El-Luhb/LattePanda-Mu/(threads)

Thread 2 (2024-05-25):

Mounting Holes on the nvme Carrier

El-Luhb, 2024-05-25:
Mounting holes must be checked to ensure that they have the correct dimensions

Closed 2024-09-20.
