El-Luhb/LattePanda-Mu/Electricals/Examples/nvme Carrier for LattePanda Mu/LattePanda Module.kicad_sch

## KiCad design Electricals/Examples/nvme Carrier for LattePanda Mu/LattePanda Module.kicad_sch (2024-06-21)

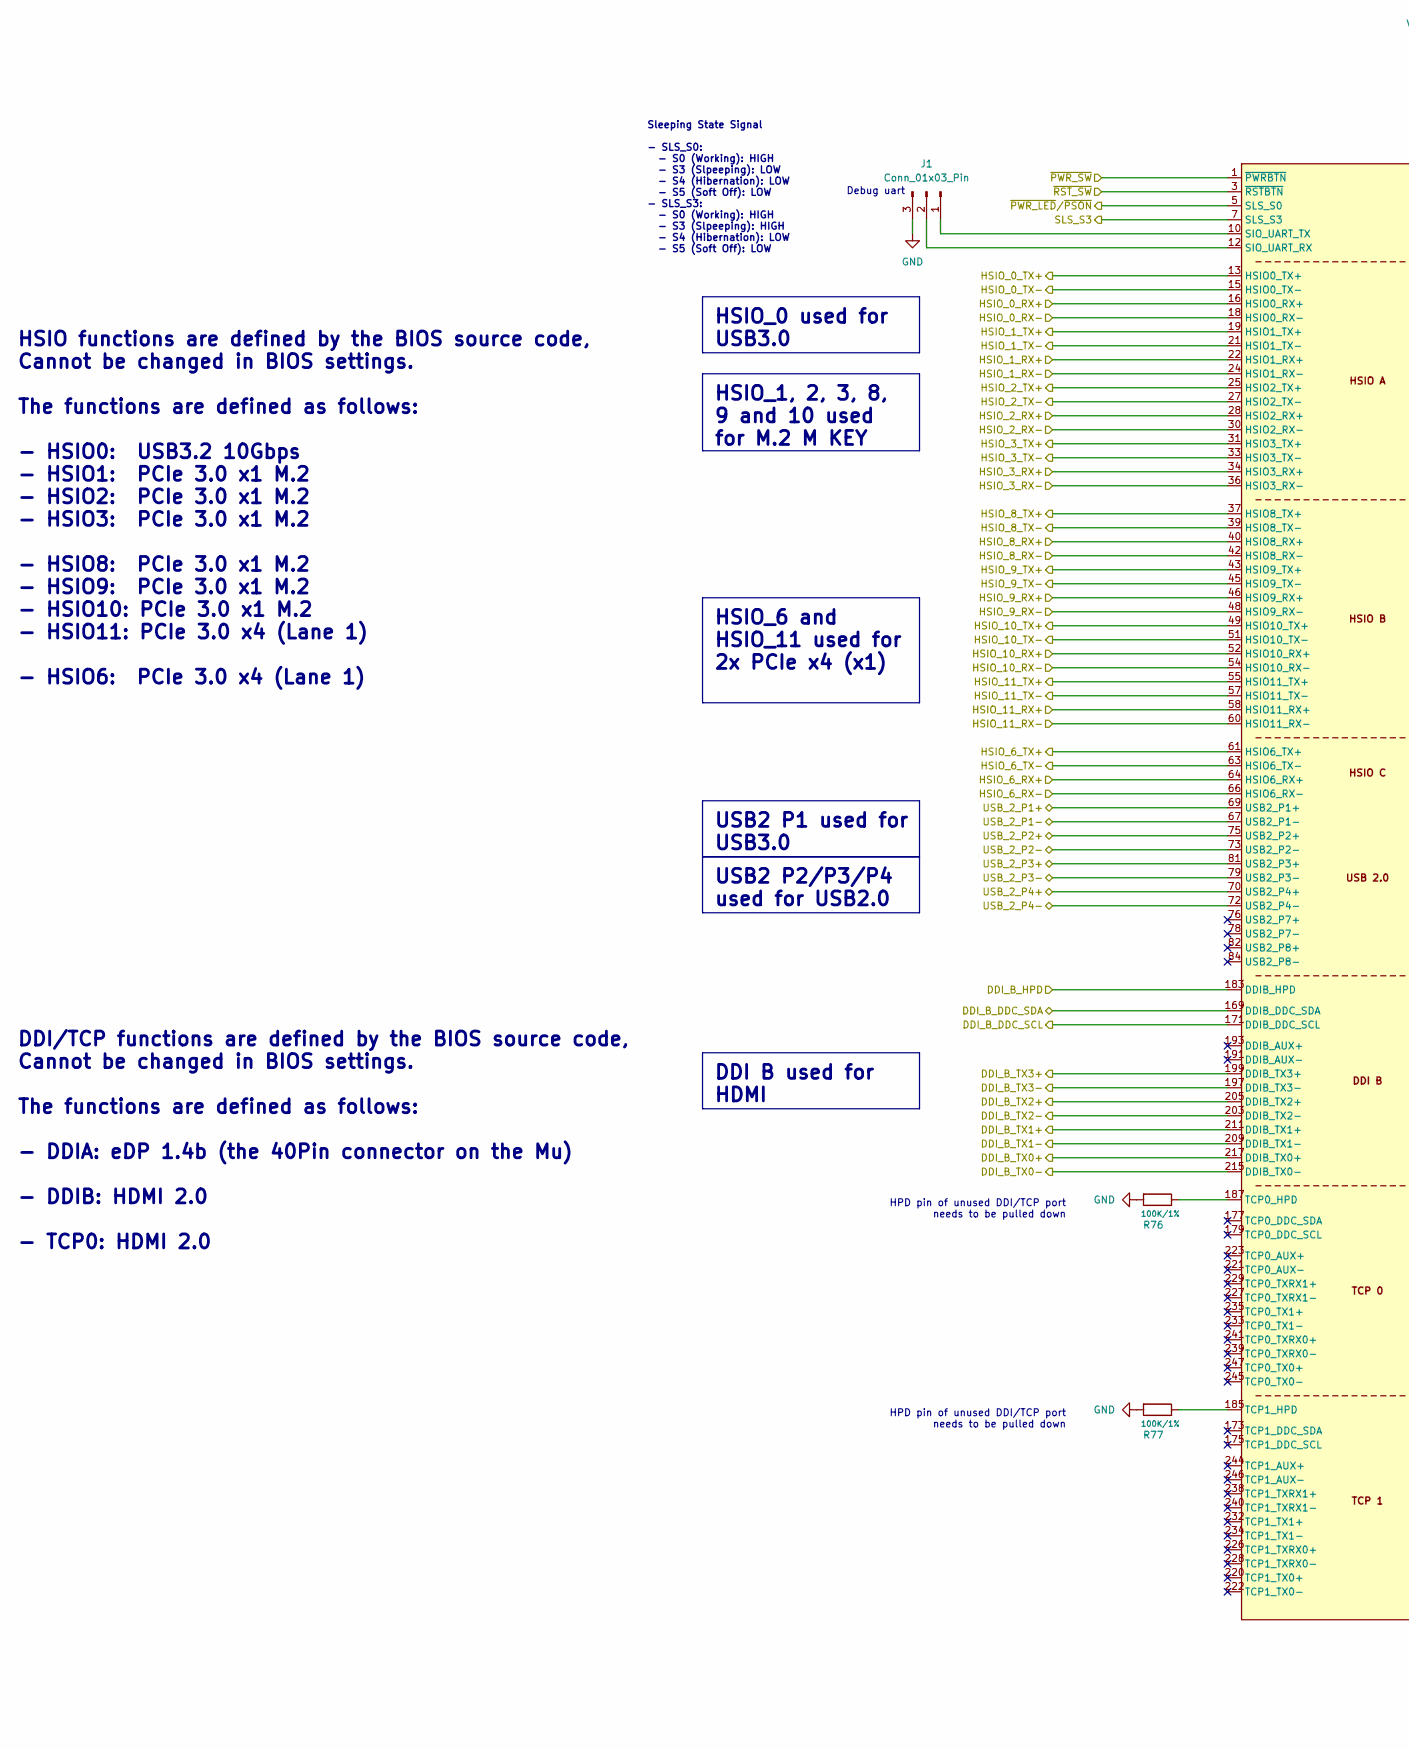
[picture p1: schematic LattePanda Module.kicad_sch, part in row 1, column 1]

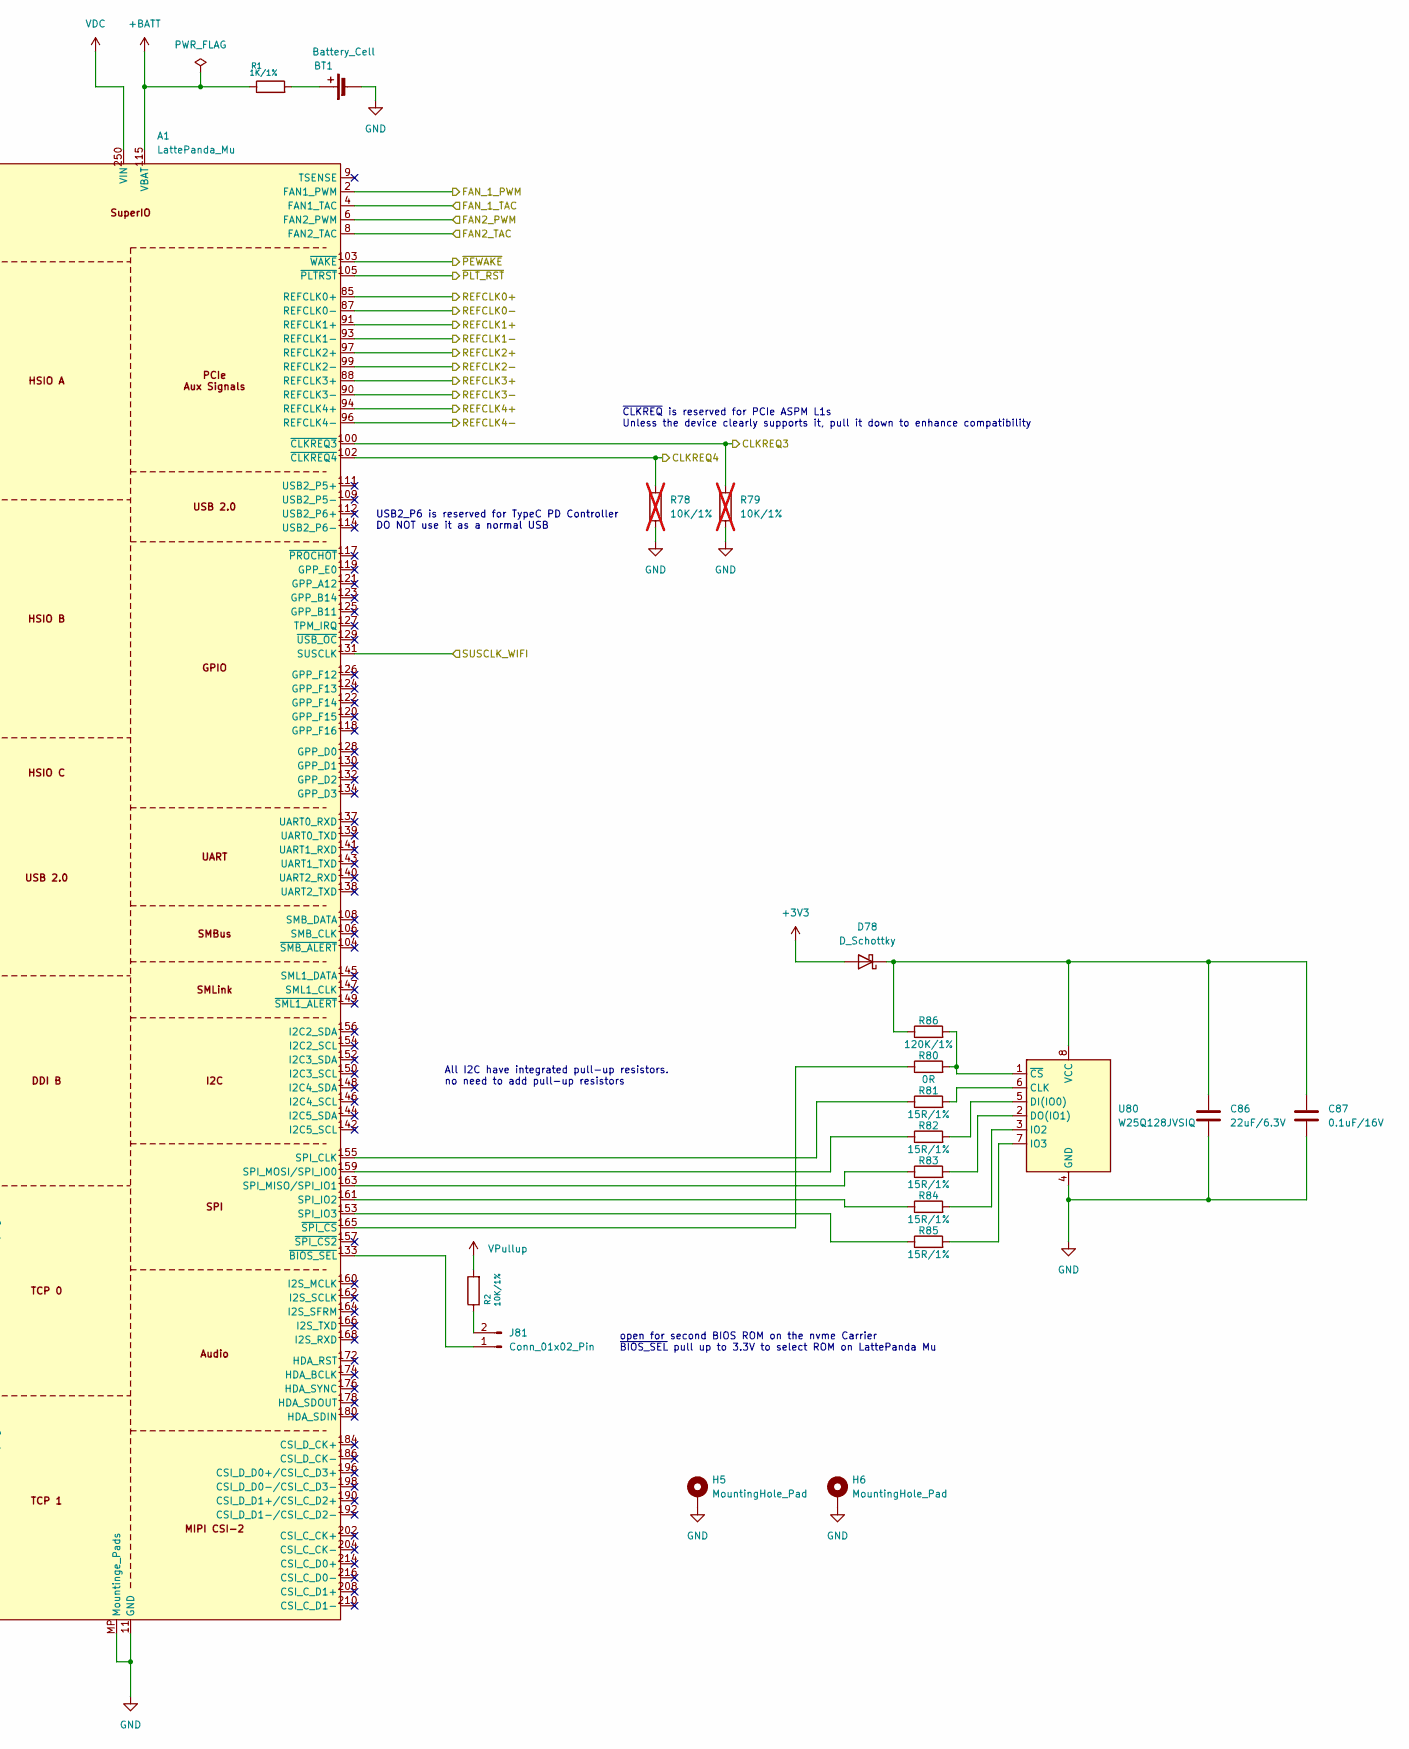
[picture p2: schematic LattePanda Module.kicad_sch, part in row 1, column 2]

Parts:
A1: LattePanda_Mu; LattePanda_Module_H8.0mm_Horizontal
BT1: Battery_Cell; Battery_Holder_CR1220_S8411-45R
C86: 22uF/6.3V; C_0402_1005Metric
C87: 0.1uF/16V; C_0402_1005Metric
D78: D_Schottky; D_SOD-923
H5, H6: MountingHole_Pad; MountingHole_3mm_M2_Pad_TopOnly
J1: Conn_01x03_Pin; PinHeader_1x03_P2.54mm_Vertical
J81: Conn_01x02_Pin; PinHeader_1x02_P2.54mm_Vertical
R1: 1K/1%; R_0402_1005Metric
R2: 10K/1%; R_0402_1005Metric
R76, R77: 100K/1%; R_0402_1005Metric
R78, R79: 10K/1%; R_0402_1005Metric; not fitted
R80: 0R; R_0402_1005Metric
R81, R82, R83, R84, R85: 15R/1%; R_0402_1005Metric
R86: 120K/1%; R_0402_1005Metric
U80: W25Q128JVSIQ; SOIC-8_5.23x5.23mm_P1.27mm

Connections:
+3V3: D78.2 (A)
+BATT: A1.115 (VBAT), R1.1
CLKREQ3: A1.100 (~CLKREQ3), R79.1
CLKREQ4: A1.102 (~CLKREQ4), R78.1
DDI_B_DDC_SCL: A1.171 (DDIB_DDC_SCL)
DDI_B_DDC_SDA: A1.169 (DDIB_DDC_SDA)
DDI_B_HPD: A1.183 (DDIB_HPD)
DDI_B_TX0+: A1.217 (DDIB_TX0+)
DDI_B_TX0-: A1.215 (DDIB_TX0-)
DDI_B_TX1+: A1.211 (DDIB_TX1+)
DDI_B_TX1-: A1.209 (DDIB_TX1-)
DDI_B_TX2+: A1.205 (DDIB_TX2+)
DDI_B_TX2-: A1.203 (DDIB_TX2-)
DDI_B_TX3+: A1.199 (DDIB_TX3+)
DDI_B_TX3-: A1.197 (DDIB_TX3-)
FAN2_PWM: A1.6 (FAN2_PWM)
FAN2_TAC: A1.8 (FAN2_TAC)
FAN_1_PWM: A1.2 (FAN1_PWM)
FAN_1_TAC: A1.4 (FAN1_TAC)
GND: A1.11 (GND), A1.14 (GND), A1.17 (GND), A1.20 (GND), A1.23 (GND), A1.26 (GND), A1.29 (GND), A1.32 (GND), A1.35 (GND), A1.38 (GND), A1.41 (GND), A1.44 (GND), A1.47 (GND), A1.50 (GND), A1.53 (GND), A1.56 (GND), A1.59 (GND), A1.62 (GND), A1.65 (GND), A1.68 (GND), A1.71 (GND), A1.74 (GND), A1.77 (GND), A1.80 (GND), A1.83 (GND), A1.86 (GND), A1.89 (GND), A1.92 (GND), A1.95 (GND), A1.98 (GND), A1.101 (GND), A1.107 (GND), A1.110 (GND), A1.113 (GND), A1.116 (GND), A1.135 (GND), A1.136 (GND), A1.151 (GND), A1.158 (GND), A1.167 (GND), A1.170 (GND), A1.181 (GND), A1.182 (GND), A1.188 (GND), A1.189 (GND), A1.194 (GND), A1.195 (GND), A1.200 (GND), A1.201 (GND), A1.206 (GND), A1.207 (GND), A1.212 (GND), A1.213 (GND), A1.218 (GND), A1.219 (GND), A1.224 (GND), A1.225 (GND), A1.230 (GND), A1.231 (GND), A1.236 (GND), A1.237 (GND), A1.242 (GND), A1.243 (GND), A1.248 (GND), A1.249 (GND), A1.MP (Mountinge_Pads), BT1.2 (-), C86.2, C87.2, H5.1, H6.1, J1.3, R76.2, R77.2, R78.2, R79.2, U80.4 (GND)
HSIO_0_RX+: A1.16 (HSIO0_RX+)
HSIO_0_RX-: A1.18 (HSIO0_RX-)
HSIO_0_TX+: A1.13 (HSIO0_TX+)
HSIO_0_TX-: A1.15 (HSIO0_TX-)
HSIO_1_RX+: A1.22 (HSIO1_RX+)
HSIO_1_RX-: A1.24 (HSIO1_RX-)
HSIO_1_TX+: A1.19 (HSIO1_TX+)
HSIO_1_TX-: A1.21 (HSIO1_TX-)
HSIO_2_RX+: A1.28 (HSIO2_RX+)
HSIO_2_RX-: A1.30 (HSIO2_RX-)
HSIO_2_TX+: A1.25 (HSIO2_TX+)
HSIO_2_TX-: A1.27 (HSIO2_TX-)
HSIO_3_RX+: A1.34 (HSIO3_RX+)
HSIO_3_RX-: A1.36 (HSIO3_RX-)
HSIO_3_TX+: A1.31 (HSIO3_TX+)
HSIO_3_TX-: A1.33 (HSIO3_TX-)
HSIO_6_RX+: A1.64 (HSIO6_RX+)
HSIO_6_RX-: A1.66 (HSIO6_RX-)
HSIO_6_TX+: A1.61 (HSIO6_TX+)
HSIO_6_TX-: A1.63 (HSIO6_TX-)
HSIO_8_RX+: A1.40 (HSIO8_RX+)
HSIO_8_RX-: A1.42 (HSIO8_RX-)
HSIO_8_TX+: A1.37 (HSIO8_TX+)
HSIO_8_TX-: A1.39 (HSIO8_TX-)
HSIO_9_RX+: A1.46 (HSIO9_RX+)
HSIO_9_RX-: A1.48 (HSIO9_RX-)
HSIO_9_TX+: A1.43 (HSIO9_TX+)
HSIO_9_TX-: A1.45 (HSIO9_TX-)
HSIO_10_RX+: A1.52 (HSIO10_RX+)
HSIO_10_RX-: A1.54 (HSIO10_RX-)
HSIO_10_TX+: A1.49 (HSIO10_TX+)
HSIO_10_TX-: A1.51 (HSIO10_TX-)
HSIO_11_RX+: A1.58 (HSIO11_RX+)
HSIO_11_RX-: A1.60 (HSIO11_RX-)
HSIO_11_TX+: A1.55 (HSIO11_TX+)
HSIO_11_TX-: A1.57 (HSIO11_TX-)
unnamed: A1.10 (SIO_UART_TX), J1.1
unnamed: A1.12 (SIO_UART_RX), J1.2
unnamed: A1.133 (~BIOS_SEL), J81.1
unnamed: A1.153 (SPI_IO3), R85.1
unnamed: A1.155 (SPI_CLK), R81.1
unnamed: A1.159 (SPI_MOSI/SPI_IO0), R82.1
unnamed: A1.161 (SPI_IO2), R84.1
unnamed: A1.163 (SPI_MISO/SPI_IO1), R83.1
unnamed: A1.165 (~SPI_CS), R80.1
unnamed: A1.185 (TCP1_HPD), R77.1
unnamed: A1.187 (TCP0_HPD), R76.1
unnamed: BT1.1 (+), R1.2
unnamed: C86.1, C87.1, D78.1 (K), R86.1, U80.8 (VCC)
unnamed: J81.2, R2.1
unnamed: R80.2, R86.2, U80.1 (~CS)
unnamed: R81.2, U80.6 (CLK)
unnamed: R82.2, U80.5 (DI(IO0))
unnamed: R83.2, U80.2 (DO(IO1))
unnamed: R84.2, U80.3 (IO2)
unnamed: R85.2, U80.7 (IO3)
REFCLK0+: A1.85 (REFCLK0+)
REFCLK0-: A1.87 (REFCLK0-)
REFCLK1+: A1.91 (REFCLK1+)
REFCLK1-: A1.93 (REFCLK1-)
REFCLK2+: A1.97 (REFCLK2+)
REFCLK2-: A1.99 (REFCLK2-)
REFCLK3+: A1.88 (REFCLK3+)
REFCLK3-: A1.90 (REFCLK3-)
REFCLK4+: A1.94 (REFCLK4+)
REFCLK4-: A1.96 (REFCLK4-)
SLS_S3: A1.7 (SLS_S3)
SUSCLK_WIFI: A1.131 (SUSCLK)
USB_2_P1+: A1.69 (USB2_P1+)
USB_2_P1-: A1.67 (USB2_P1-)
USB_2_P2+: A1.75 (USB2_P2+)
USB_2_P2-: A1.73 (USB2_P2-)
USB_2_P3+: A1.81 (USB2_P3+)
USB_2_P3-: A1.79 (USB2_P3-)
USB_2_P4+: A1.70 (USB2_P4+)
USB_2_P4-: A1.72 (USB2_P4-)
VDC: A1.250 (VIN), A1.251 (VIN), A1.252 (VIN), A1.253 (VIN), A1.254 (VIN), A1.255 (VIN), A1.256 (VIN), A1.257 (VIN), A1.258 (VIN), A1.259 (VIN), A1.260 (VIN)
VPullup: R2.2
~PEWAKE: A1.103 (~WAKE)
~PLT_RST: A1.105 (~PLTRST)
~PWR_LED/~PSON: A1.5 (SLS_S0)
~PWR_SW: A1.1 (~PWRBTN)
~RST_SW: A1.3 (~RSTBTN)

Notes on the sheet:
HSIO_0 used for USB3.0
HSIO_1, 2, 3, 8, 9 and 10 used for M.2 M KEY
USB2 P2/P3/P4 used for USB2.0
DDI B used for HDMI
HSIO_6 and HSIO_11 used for 2x PCIe x4 (x1)
USB2 P1 used for USB3.0
HSIO functions are defined by the BIOS source code, Cannot be changed in BIOS settings. The functions are defined as follows: - HSIO0: USB3.2 10Gbps - HSIO1: PCIe 3.0 x1 M.2 - HSIO2: PCIe 3.0 x1 M.2 - HSIO3: PCIe 3.0 x1 M.2 - HSIO8: PCIe 3.0 x1 M.2 - HSIO9: PCIe 3.0 x1 M.2 - HSIO10: PCIe 3.0 x1 M.2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
HPD pin of unused DDI/TCP port needs to be pulled down
open for second BIOS ROM on the nvme Carrier ~{BIOS_SEL} pull up to 3.3V to select ROM on LattePanda Mu
DDI/TCP functions are defined by the BIOS source code, Cannot be changed in BIOS settings. The functions are defined as follows: - DDIA: eDP 1.4b (the 40Pin connector on the Mu) - DDIB: HDMI 2.0 - TCP0: HDMI 2.0
Sleeping State Signal - SLS_S0: - S0 (Working): HIGH - S3 (Slpeeping): LOW - S4 (Hibernation): LOW - S5 (Soft Off): LOW - SLS_S3: - S0 (Working): HIGH - S3 (Slpeeping): HIGH - S4 (Hibernation): LOW - S5 (Soft Off): LOW
USB2_P6 is reserved for TypeC PD Controller DO NOT use it as a normal USB
All I2C have integrated pull-up resistors. no need to add pull-up resistors
Debug uart
~{CLKREQ} is reserved for PCIe ASPM L1s Unless the device clearly supports it, pull it down to enhance compatibility
