El-Luhb/LattePanda-Mu/Electricals/Examples/nvme Carrier for LattePanda Mu/M.2 M Key.kicad_sch

## KiCad design Electricals/Examples/nvme Carrier for LattePanda Mu/M.2 M Key.kicad_sch (2024-06-21)

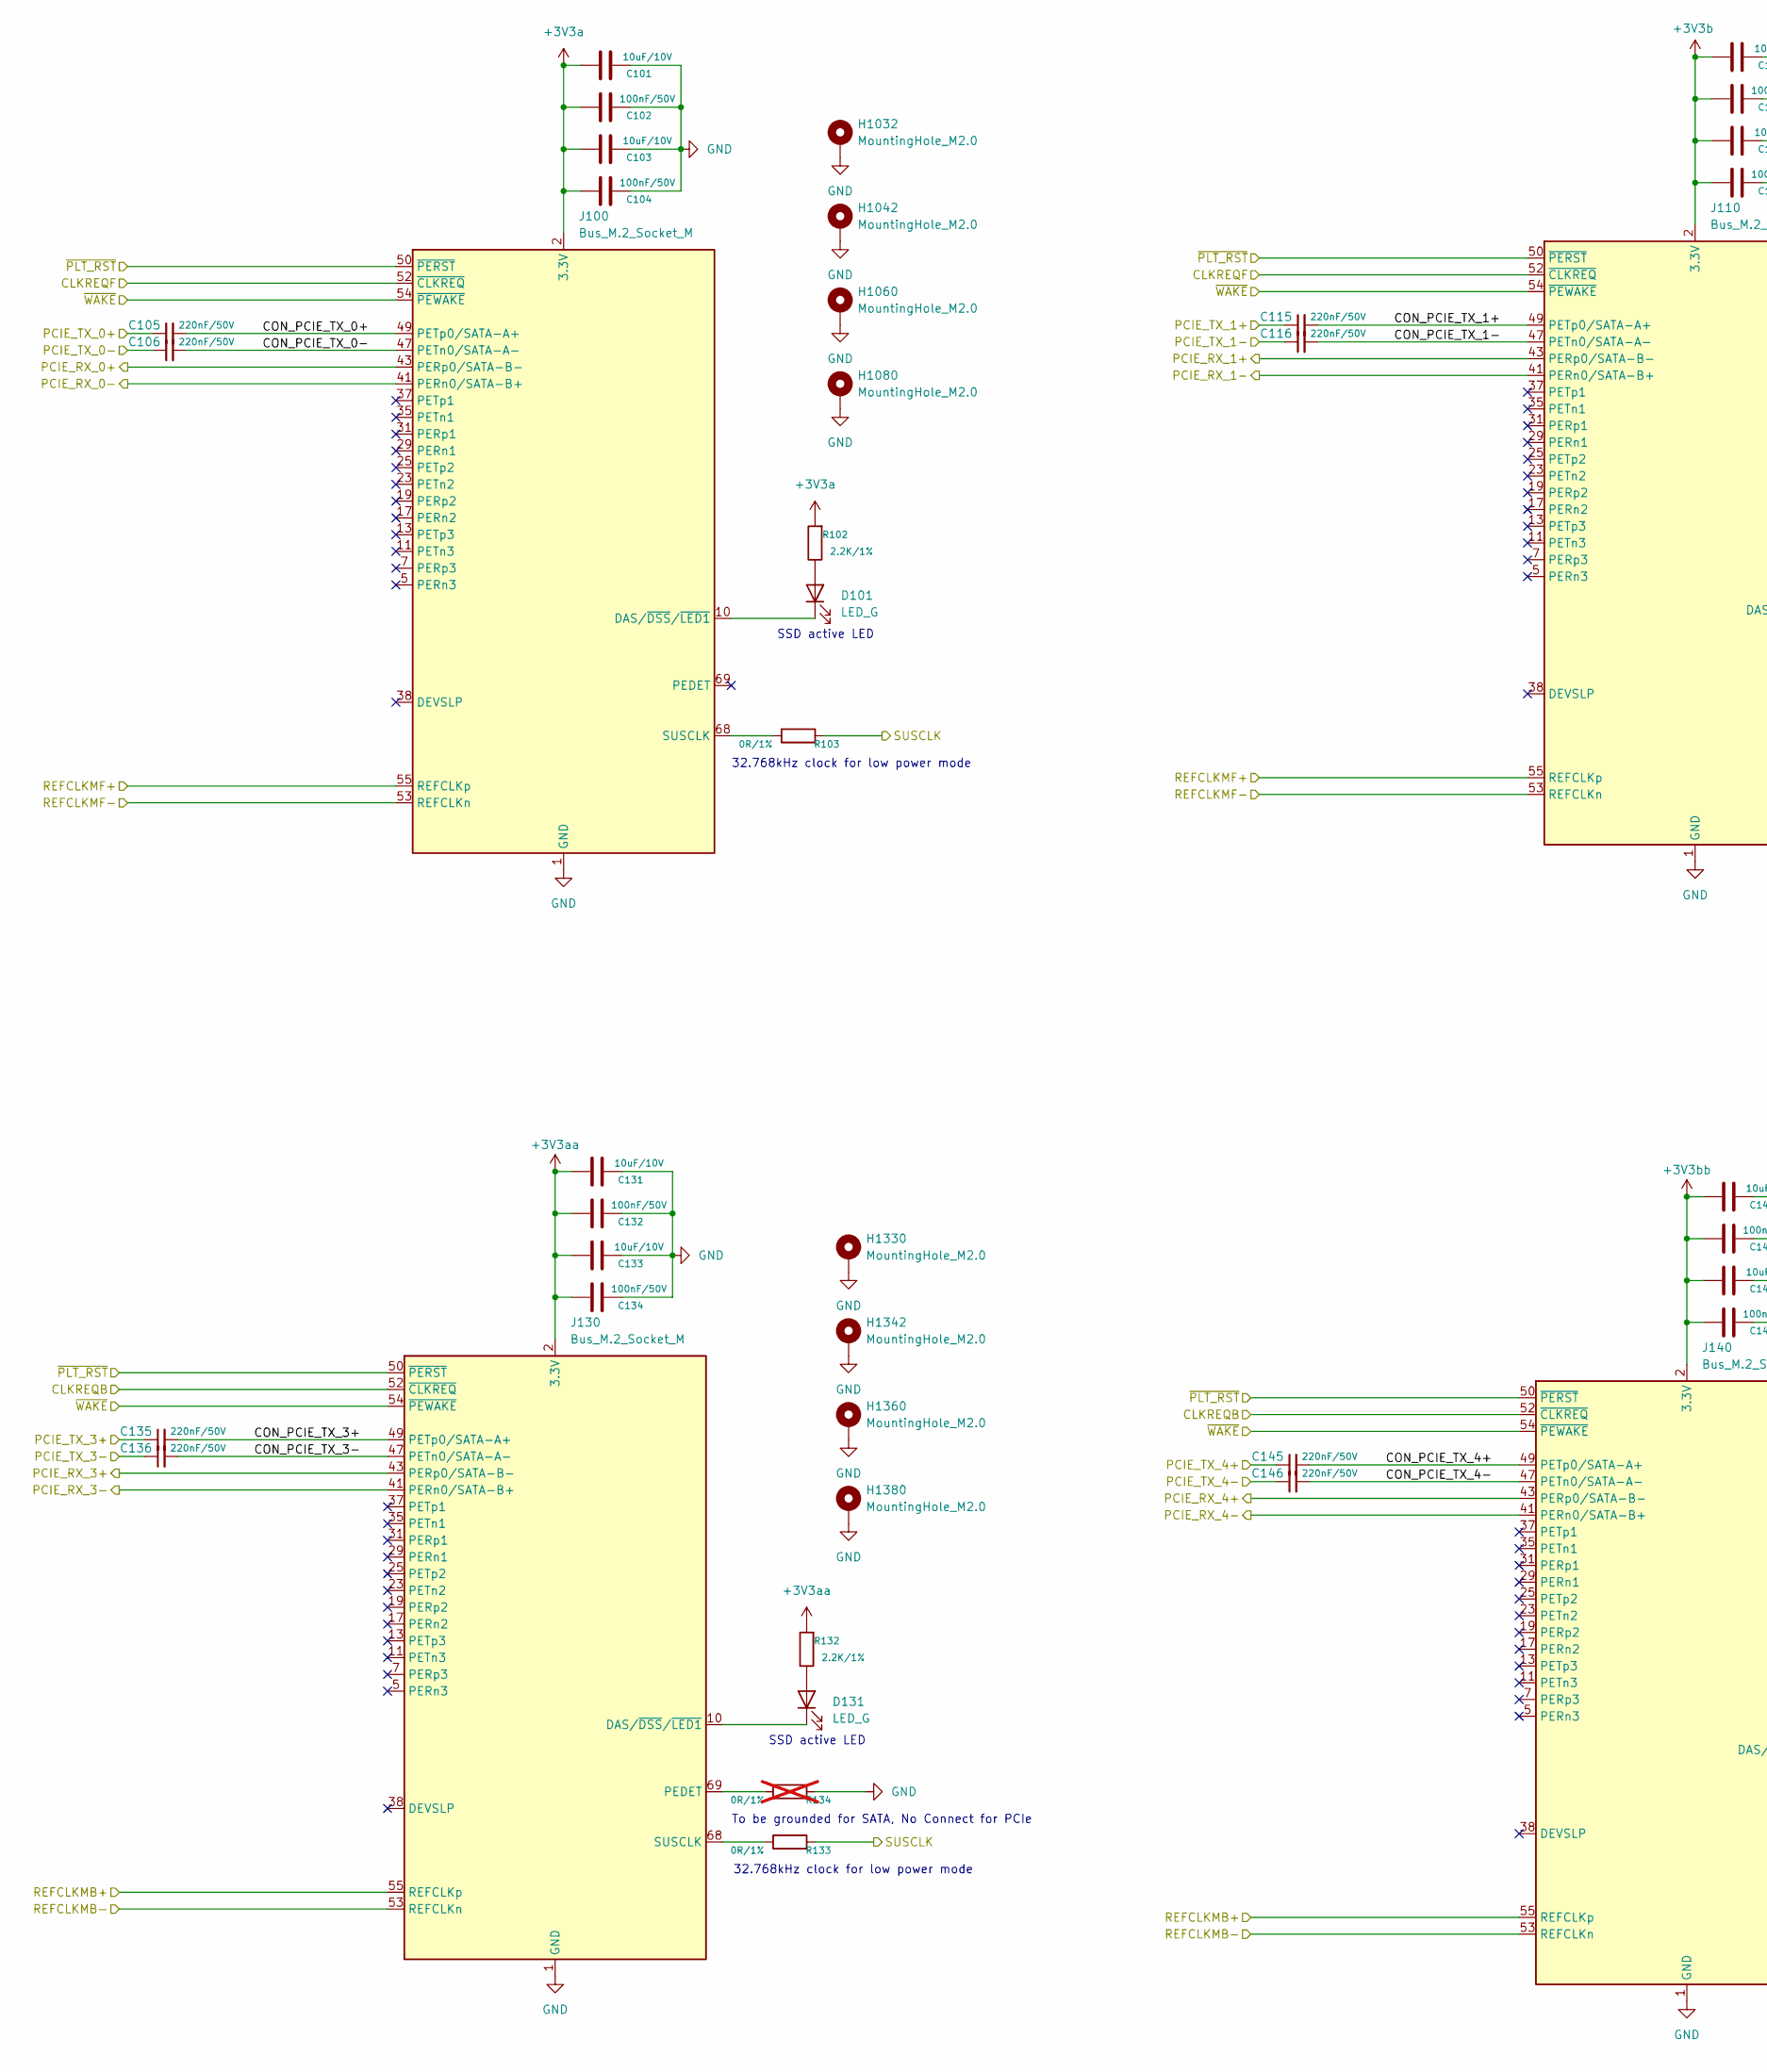
[picture p3: schematic M.2 M Key.kicad_sch, part in row 1, column 1]

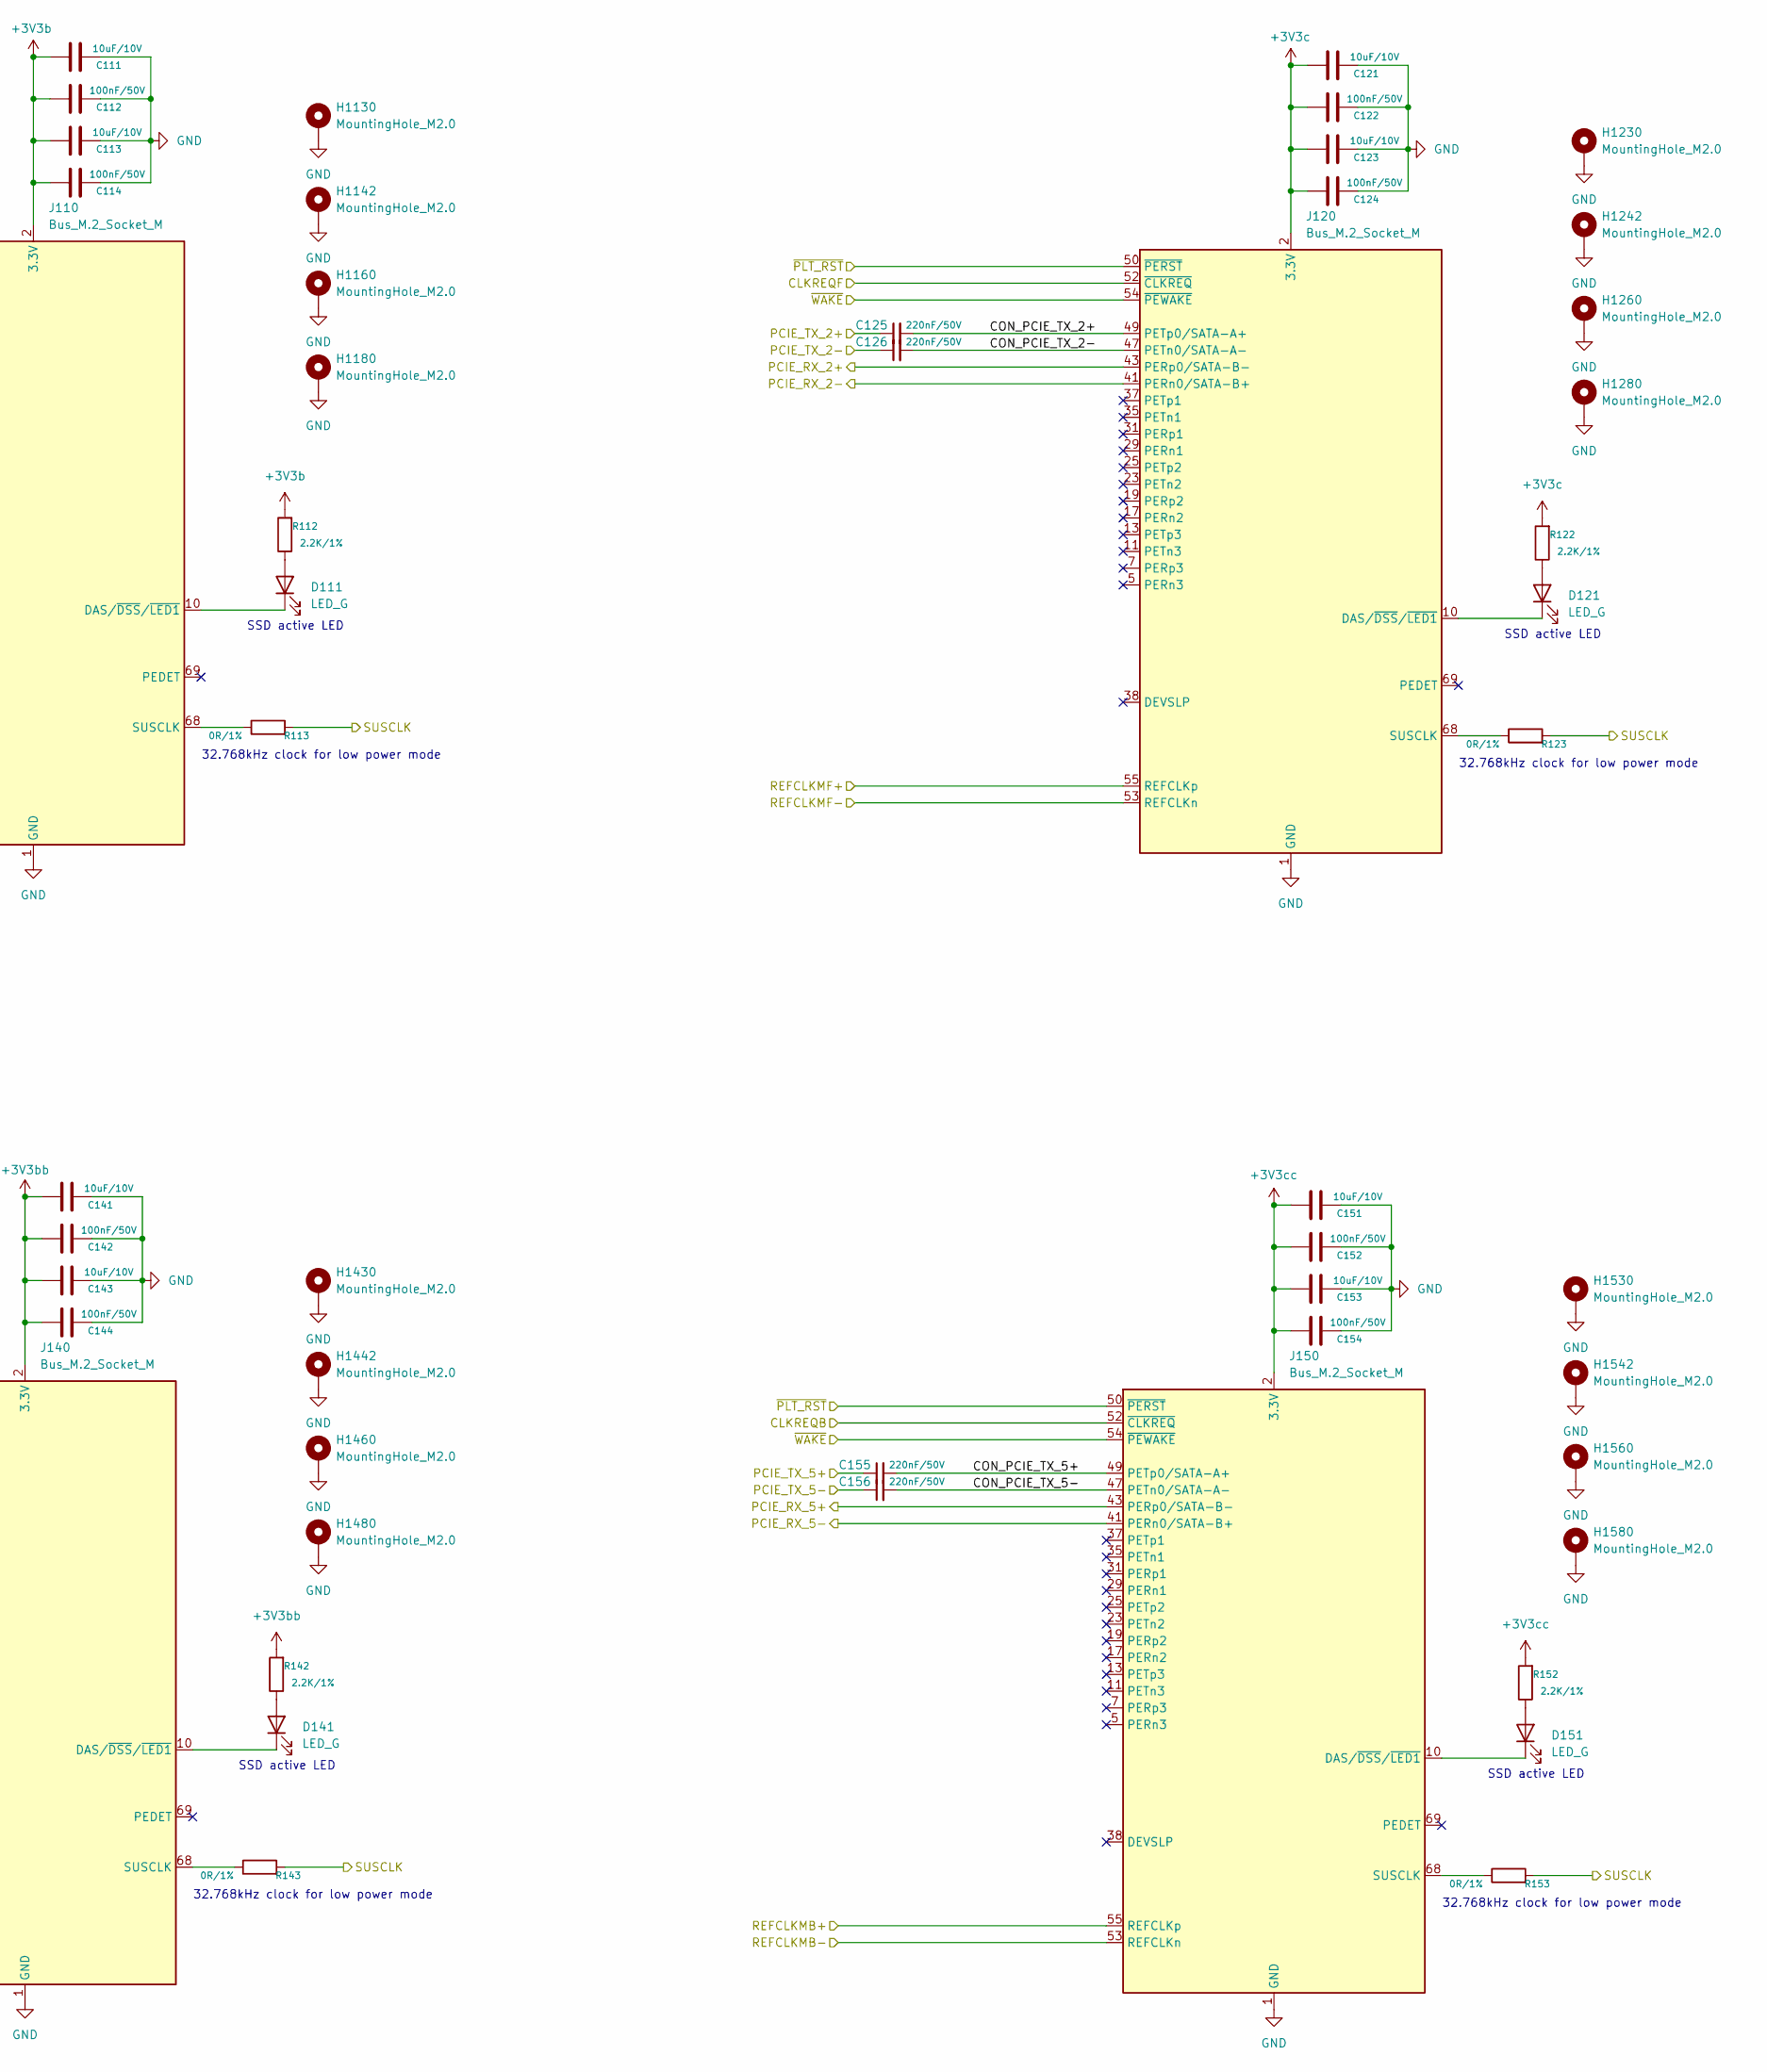
[picture p4: schematic M.2 M Key.kicad_sch, part in row 1, column 2]

Parts:
C101, C103, C111, C113, C121, C123, C131, C133, C141, C143, C151, C153: 10uF/10V; C_0402_1005Metric
C102, C104, C112, C114, C122, C124, C132, C134, C142, C144, C152, C154: 100nF/50V; C_0402_1005Metric
C105, C106, C115, C116, C125, C126, C135, C136, C145, C146, C155, C156: 220nF/50V; C_0402_1005Metric
D101, D111, D121, D131, D141, D151: LED_G; LED_0603_1608Metric
H1032, H1042, H1060, H1080, H1130, H1142, H1160, H1180, H1230, H1242, H1260, H1280, H1330, H1342, H1360, H1380, H1430, H1442, H1460, H1480, H1530, H1542, H1560, H1580: MountingHole_M2.0; MountingHole_2.7mm_M2.5_DIN965_Pad_TopBottom
J100, J110, J120, J130, J140, J150: Bus_M.2_Socket_M; PCIe_M.2_Connectors_P=0.5mm_H=4.2mm_KeyM
R102, R112, R122, R132, R142, R152: 2.2K/1%; R_0402_1005Metric
R103, R113, R123, R133, R143, R153: 0R/1%; R_0402_1005Metric
R134: 0R/1%; R_0402_1005Metric; not fitted

Connections:
+3V3a: C101.2, C102.2, C103.2, C104.2, J100.2 (3.3V), J100.4 (3.3V), J100.12 (3.3V), J100.14 (3.3V), J100.16 (3.3V), J100.18 (3.3V), J100.70 (3.3V), J100.72 (3.3V), J100.74 (3.3V), R102.2
+3V3aa: C131.2, C132.2, C133.2, C134.2, J130.2 (3.3V), J130.4 (3.3V), J130.12 (3.3V), J130.14 (3.3V), J130.16 (3.3V), J130.18 (3.3V), J130.70 (3.3V), J130.72 (3.3V), J130.74 (3.3V), R132.2
+3V3b: C111.2, C112.2, C113.2, C114.2, J110.2 (3.3V), J110.4 (3.3V), J110.12 (3.3V), J110.14 (3.3V), J110.16 (3.3V), J110.18 (3.3V), J110.70 (3.3V), J110.72 (3.3V), J110.74 (3.3V), R112.2
+3V3bb: C141.2, C142.2, C143.2, C144.2, J140.2 (3.3V), J140.4 (3.3V), J140.12 (3.3V), J140.14 (3.3V), J140.16 (3.3V), J140.18 (3.3V), J140.70 (3.3V), J140.72 (3.3V), J140.74 (3.3V), R142.2
+3V3c: C121.2, C122.2, C123.2, C124.2, J120.2 (3.3V), J120.4 (3.3V), J120.12 (3.3V), J120.14 (3.3V), J120.16 (3.3V), J120.18 (3.3V), J120.70 (3.3V), J120.72 (3.3V), J120.74 (3.3V), R122.2
+3V3cc: C151.2, C152.2, C153.2, C154.2, J150.2 (3.3V), J150.4 (3.3V), J150.12 (3.3V), J150.14 (3.3V), J150.16 (3.3V), J150.18 (3.3V), J150.70 (3.3V), J150.72 (3.3V), J150.74 (3.3V), R152.2
CLKREQB: J130.52 (~CLKREQ), J140.52 (~CLKREQ), J150.52 (~CLKREQ)
CLKREQF: J100.52 (~CLKREQ), J110.52 (~CLKREQ), J120.52 (~CLKREQ)
CON_PCIE_TX_0+: C105.2, J100.49 (PETp0/SATA-A+)
CON_PCIE_TX_0-: C106.2, J100.47 (PETn0/SATA-A-)
CON_PCIE_TX_1+: C115.2, J110.49 (PETp0/SATA-A+)
CON_PCIE_TX_1-: C116.2, J110.47 (PETn0/SATA-A-)
CON_PCIE_TX_2+: C125.2, J120.49 (PETp0/SATA-A+)
CON_PCIE_TX_2-: C126.2, J120.47 (PETn0/SATA-A-)
CON_PCIE_TX_3+: C135.2, J130.49 (PETp0/SATA-A+)
CON_PCIE_TX_3-: C136.2, J130.47 (PETn0/SATA-A-)
CON_PCIE_TX_4+: C145.2, J140.49 (PETp0/SATA-A+)
CON_PCIE_TX_4-: C146.2, J140.47 (PETn0/SATA-A-)
CON_PCIE_TX_5+: C155.2, J150.49 (PETp0/SATA-A+)
CON_PCIE_TX_5-: C156.2, J150.47 (PETn0/SATA-A-)
GND: C101.1, C102.1, C103.1, C104.1, C111.1, C112.1, C113.1, C114.1, C121.1, C122.1, C123.1, C124.1, C131.1, C132.1, C133.1, C134.1, C141.1, C142.1, C143.1, C144.1, C151.1, C152.1, C153.1, C154.1, H1032.1, H1042.1, H1060.1, H1080.1, H1130.1, H1142.1, H1160.1, H1180.1, H1230.1, H1242.1, H1260.1, H1280.1, H1330.1, H1342.1, H1360.1, H1380.1, H1430.1, H1442.1, H1460.1, H1480.1, H1530.1, H1542.1, H1560.1, H1580.1, J100.1 (GND), J100.3 (GND), J100.9 (GND), J100.15 (GND), J100.21 (GND), J100.27 (GND), J100.33 (GND), J100.39 (GND), J100.45 (GND), J100.51 (GND), J100.57 (GND), J100.71 (GND), J100.73 (GND), J100.75 (GND), J100.MP1, J100.MP2, J110.1 (GND), J110.3 (GND), J110.9 (GND), J110.15 (GND), J110.21 (GND), J110.27 (GND), J110.33 (GND), J110.39 (GND), J110.45 (GND), J110.51 (GND), J110.57 (GND), J110.71 (GND), J110.73 (GND), J110.75 (GND), J110.MP1, J110.MP2, J120.1 (GND), J120.3 (GND), J120.9 (GND), J120.15 (GND), J120.21 (GND), J120.27 (GND), J120.33 (GND), J120.39 (GND), J120.45 (GND), J120.51 (GND), J120.57 (GND), J120.71 (GND), J120.73 (GND), J120.75 (GND), J120.MP1, J120.MP2, J130.1 (GND), J130.3 (GND), J130.9 (GND), J130.15 (GND), J130.21 (GND), J130.27 (GND), J130.33 (GND), J130.39 (GND), J130.45 (GND), J130.51 (GND), J130.57 (GND), J130.71 (GND), J130.73 (GND), J130.75 (GND), J130.MP1, J130.MP2, J140.1 (GND), J140.3 (GND), J140.9 (GND), J140.15 (GND), J140.21 (GND), J140.27 (GND), J140.33 (GND), J140.39 (GND), J140.45 (GND), J140.51 (GND), J140.57 (GND), J140.71 (GND), J140.73 (GND), J140.75 (GND), J140.MP1, J140.MP2, J150.1 (GND), J150.3 (GND), J150.9 (GND), J150.15 (GND), J150.21 (GND), J150.27 (GND), J150.33 (GND), J150.39 (GND), J150.45 (GND), J150.51 (GND), J150.57 (GND), J150.71 (GND), J150.73 (GND), J150.75 (GND), J150.MP1, J150.MP2, R134.2
unnamed: D101.1 (K), J100.10 (DAS/~DSS/~LED1)
unnamed: D101.2 (A), R102.1
unnamed: D111.1 (K), J110.10 (DAS/~DSS/~LED1)
unnamed: D111.2 (A), R112.1
unnamed: D121.1 (K), J120.10 (DAS/~DSS/~LED1)
unnamed: D121.2 (A), R122.1
unnamed: D131.1 (K), J130.10 (DAS/~DSS/~LED1)
unnamed: D131.2 (A), R132.1
unnamed: D141.1 (K), J140.10 (DAS/~DSS/~LED1)
unnamed: D141.2 (A), R142.1
unnamed: D151.1 (K), J150.10 (DAS/~DSS/~LED1)
unnamed: D151.2 (A), R152.1
unnamed: J100.68 (SUSCLK), R103.1
unnamed: J110.68 (SUSCLK), R113.1
unnamed: J120.68 (SUSCLK), R123.1
unnamed: J130.68 (SUSCLK), R133.1
unnamed: J130.69 (PEDET), R134.1
unnamed: J140.68 (SUSCLK), R143.1
unnamed: J150.68 (SUSCLK), R153.1
PCIE_RX_0+: J100.43 (PERp0/SATA-B-)
PCIE_RX_0-: J100.41 (PERn0/SATA-B+)
PCIE_RX_1+: J110.43 (PERp0/SATA-B-)
PCIE_RX_1-: J110.41 (PERn0/SATA-B+)
PCIE_RX_2+: J120.43 (PERp0/SATA-B-)
PCIE_RX_2-: J120.41 (PERn0/SATA-B+)
PCIE_RX_3+: J130.43 (PERp0/SATA-B-)
PCIE_RX_3-: J130.41 (PERn0/SATA-B+)
PCIE_RX_4+: J140.43 (PERp0/SATA-B-)
PCIE_RX_4-: J140.41 (PERn0/SATA-B+)
PCIE_RX_5+: J150.43 (PERp0/SATA-B-)
PCIE_RX_5-: J150.41 (PERn0/SATA-B+)
PCIE_TX_0+: C105.1
PCIE_TX_0-: C106.1
PCIE_TX_1+: C115.1
PCIE_TX_1-: C116.1
PCIE_TX_2+: C125.1
PCIE_TX_2-: C126.1
PCIE_TX_3+: C135.1
PCIE_TX_3-: C136.1
PCIE_TX_4+: C145.1
PCIE_TX_4-: C146.1
PCIE_TX_5+: C155.1
PCIE_TX_5-: C156.1
REFCLKMB+: J130.55 (REFCLKp), J140.55 (REFCLKp), J150.55 (REFCLKp)
REFCLKMB-: J130.53 (REFCLKn), J140.53 (REFCLKn), J150.53 (REFCLKn)
REFCLKMF+: J100.55 (REFCLKp), J110.55 (REFCLKp), J120.55 (REFCLKp)
REFCLKMF-: J100.53 (REFCLKn), J110.53 (REFCLKn), J120.53 (REFCLKn)
SUSCLK: R103.2, R113.2, R123.2, R133.2, R143.2, R153.2
~PLT_RST: J100.50 (~PERST), J110.50 (~PERST), J120.50 (~PERST), J130.50 (~PERST), J140.50 (~PERST), J150.50 (~PERST)
~WAKE: J100.54 (~PEWAKE), J110.54 (~PEWAKE), J120.54 (~PEWAKE), J130.54 (~PEWAKE), J140.54 (~PEWAKE), J150.54 (~PEWAKE)

Notes on the sheet:
SSD active LED
To be grounded for SATA, No Connect for PCIe
32.768kHz clock for low power mode
