El-Luhb/LattePanda-Mu/Electricals/Examples/nvme Carrier for LattePanda Mu/PSU.kicad_sch

## KiCad design Electricals/Examples/nvme Carrier for LattePanda Mu/PSU.kicad_sch (2024-06-21)

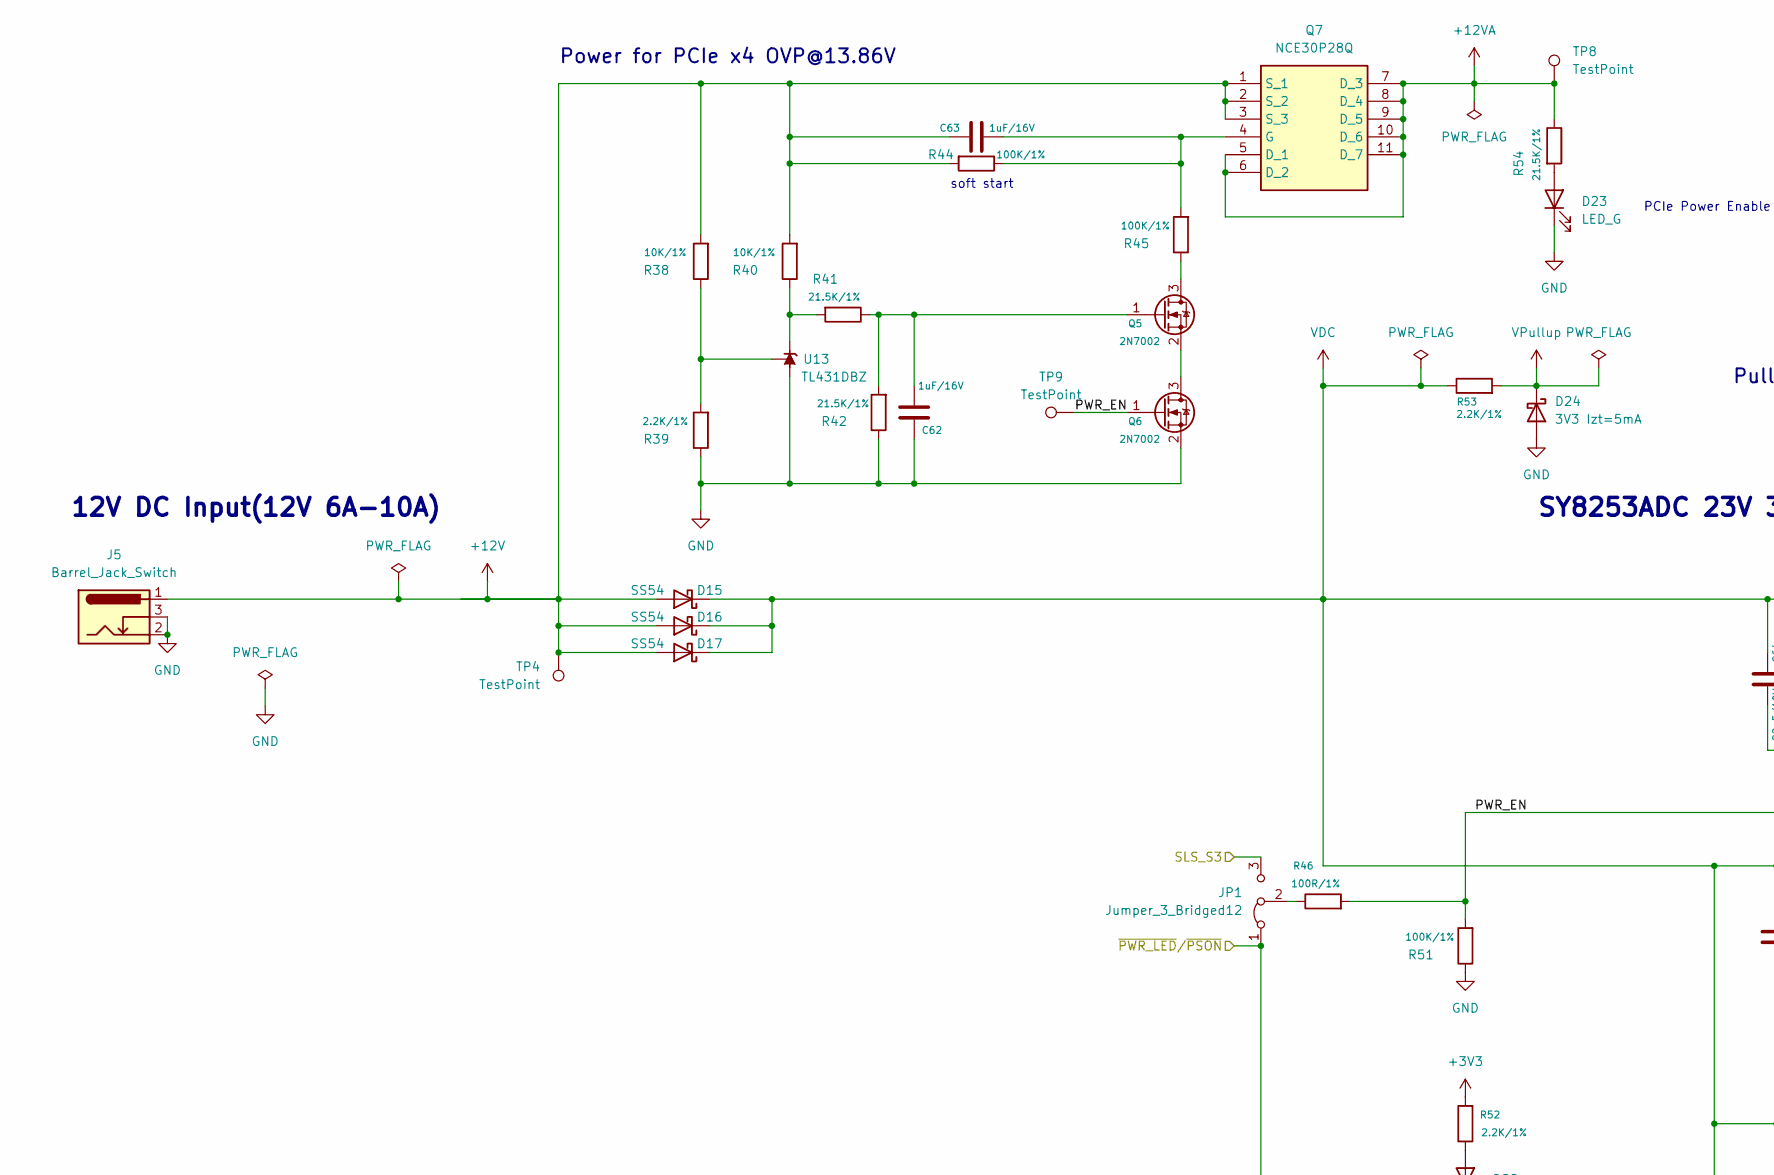
[picture p6: schematic PSU.kicad_sch, part in row 1, column 1]

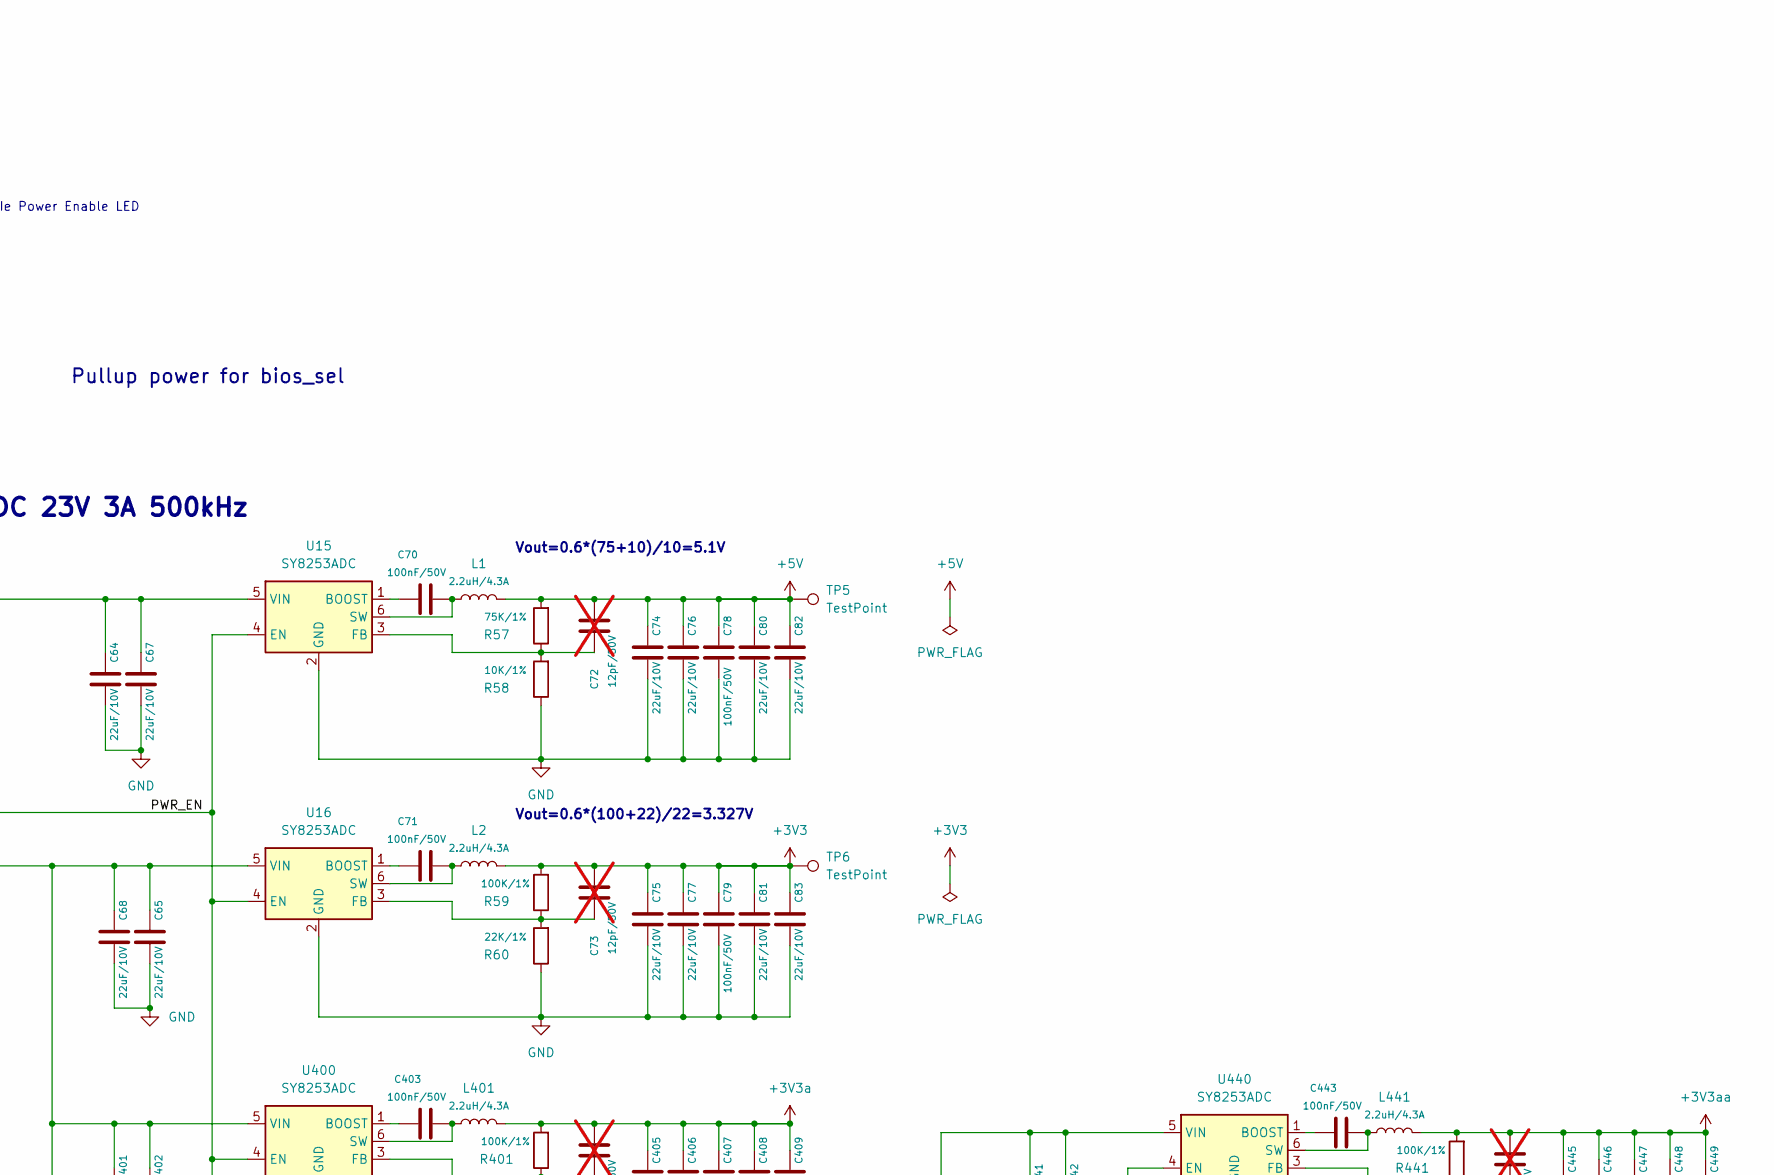
[picture p7: schematic PSU.kicad_sch, part in row 1, column 2]

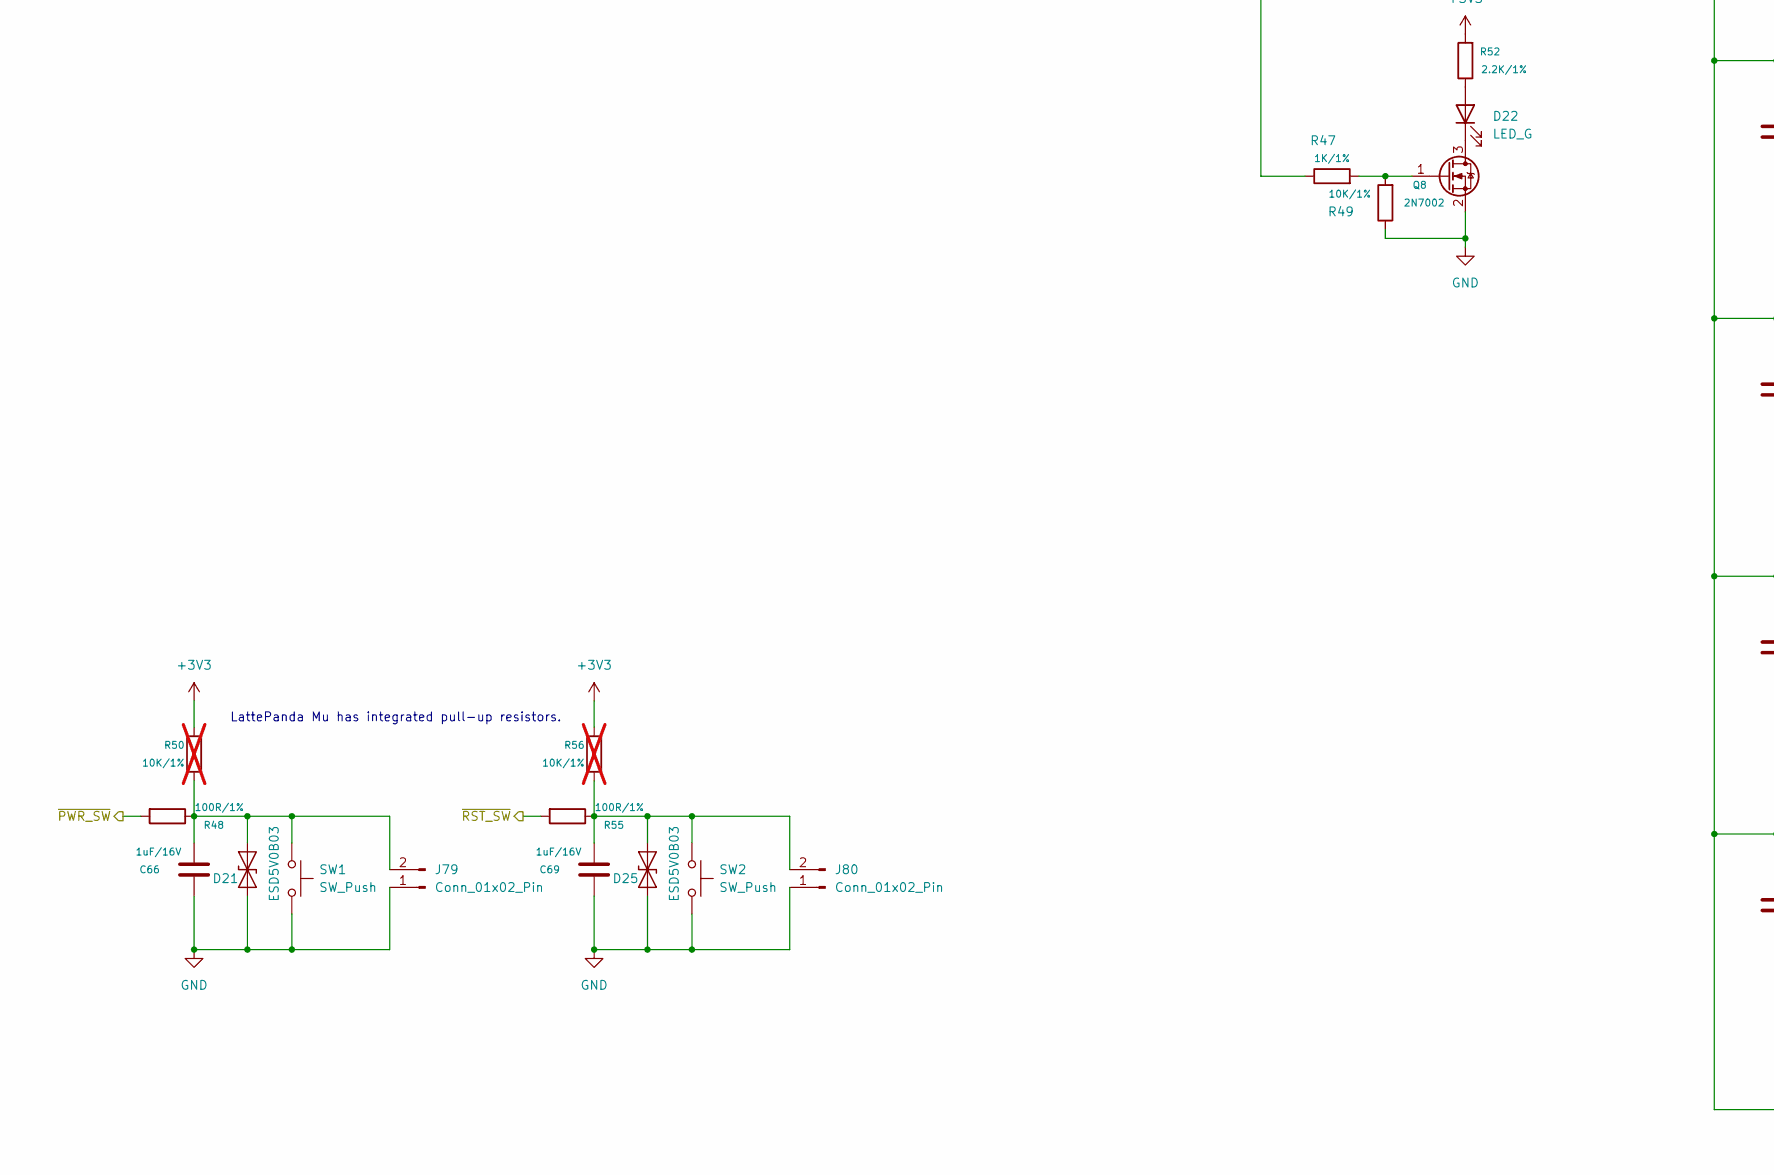
[picture p8: schematic PSU.kicad_sch, part in row 2, column 1]

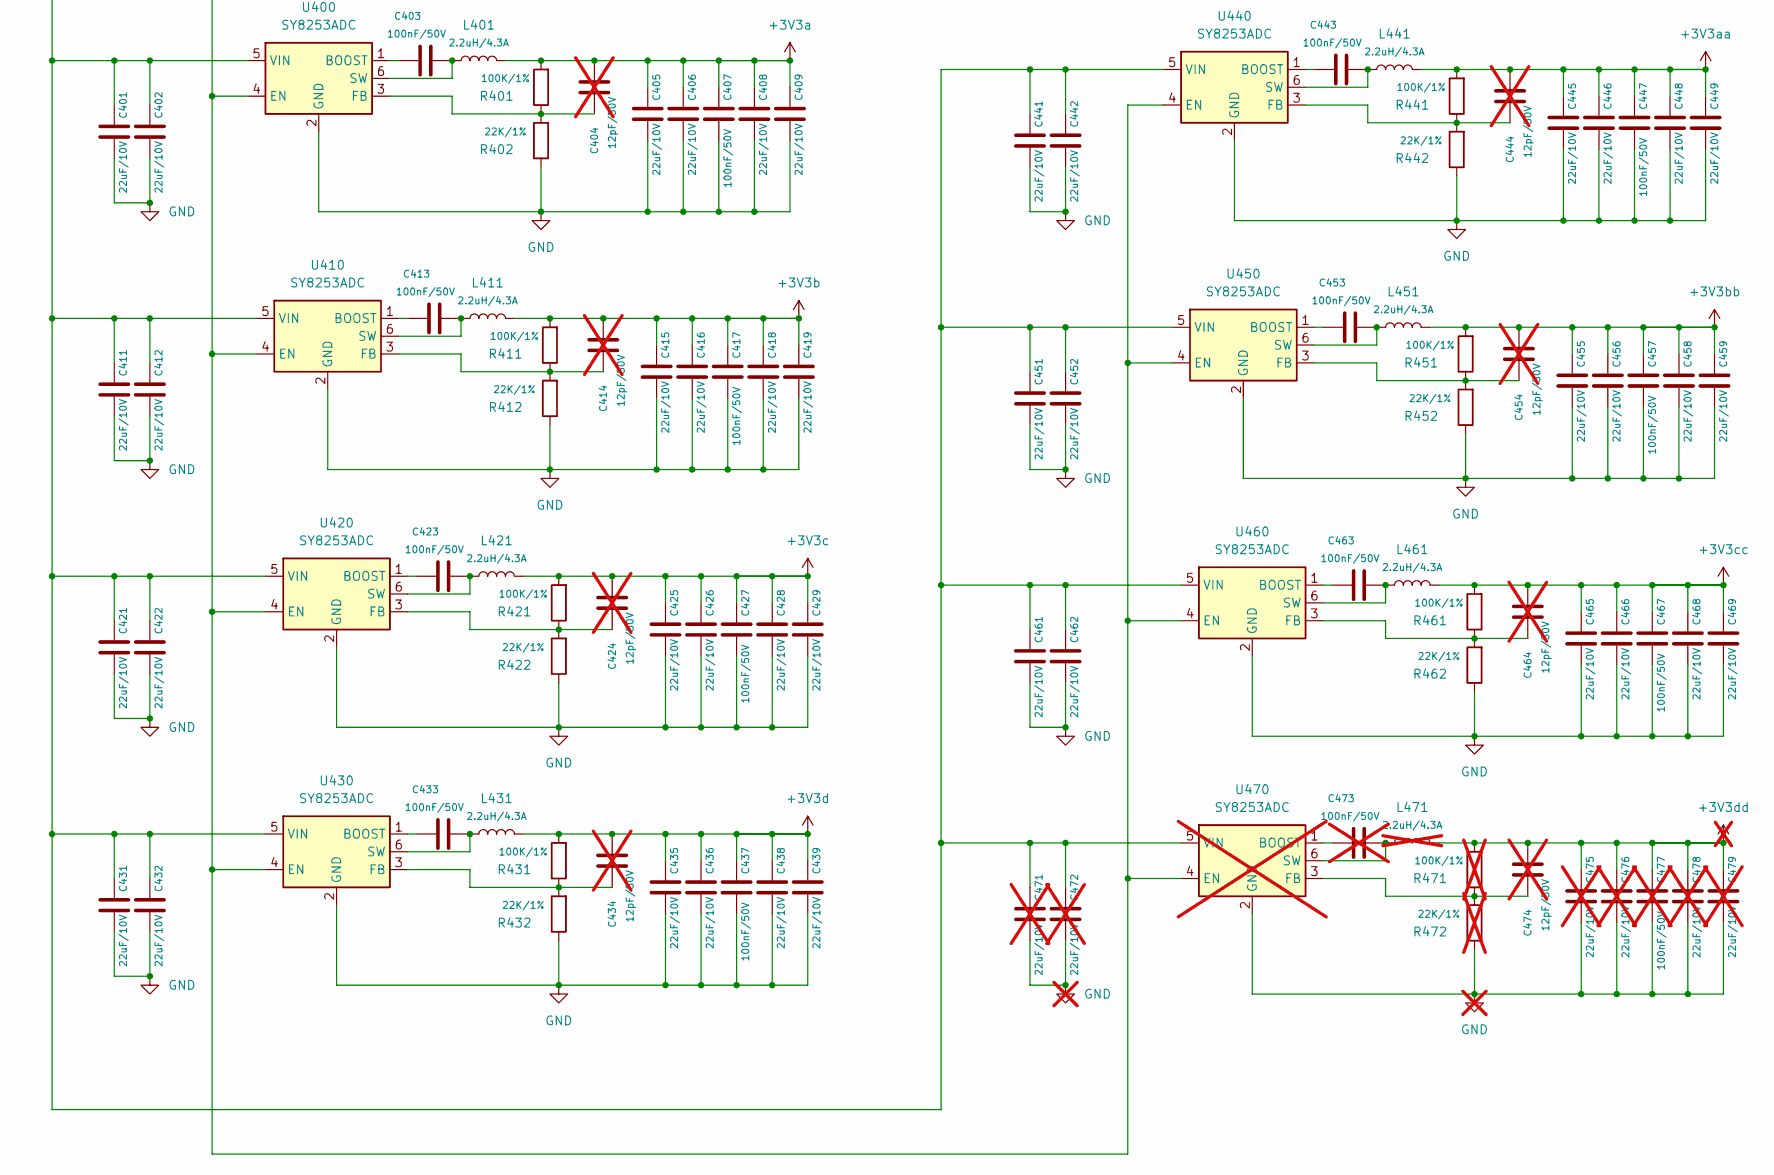
[picture p9: schematic PSU.kicad_sch, part in row 2, column 2]

Parts:
C62, C63, C66, C69: 1uF/16V; C_0402_1005Metric
C64, C65, C67, C68, C74, C75, C76, C77, C80, C81, C82, C83, C401, C402, C405, C406, C408, C409, C411, C412, C415, C416, C418, C419, C421, C422, C425, C426, C428, C429, C431, C432, C435, C436, C438, C439, C441, C442, C445, C446, C448, C449, C451, C452, C455, C456, C458, C459, C461, C462, C465, C466, C468, C469: 22uF/10V; C_0603_1608Metric
C70, C71, C78, C79, C403, C407, C413, C417, C423, C427, C433, C437, C443, C447, C453, C457, C463, C467: 100nF/50V; C_0402_1005Metric
C72, C73, C404, C414, C424, C434, C444, C454, C464, C474: 12pF/50V; C_0402_1005Metric; not fitted
C471, C472, C475, C476, C478, C479: 22uF/10V; C_0603_1608Metric; not fitted
C473, C477: 100nF/50V; C_0402_1005Metric; not fitted
D15, D16, D17: SS54; D_SMA
D21, D25: ESD5V0B03; D_0402_1005Metric
D22, D23: LED_G; LED_0603_1608Metric
D24: 3V3 Izt=5mA; D_SOD-323
J5: Barrel_Jack_Switch; DC_Jack_DC007B_30V_10A
J79, J80: Conn_01x02_Pin; PinHeader_1x02_P2.54mm_Vertical
JP1: Jumper_3_Bridged12; PinHeader_1x03_P2.54mm_Vertical
L1, L2, L401, L411, L421, L431, L441, L451, L461: 2.2uH/4.3A; L_Sunlord_SWPA4020S
L471: 2.2uH/4.3A; L_Sunlord_SWPA4020S; not fitted
Q5, Q6, Q8: 2N7002; SOT-23
Q7: NCE30P28Q; MOSFET_PDFN8_3.3x3.3
R38, R40, R49, R58: 10K/1%; R_0402_1005Metric
R39, R52, R53: 2.2K/1%; R_0402_1005Metric
R41, R42, R54: 21.5K/1%; R_0402_1005Metric
R44, R45, R51, R59, R401, R411, R421, R431, R441, R451, R461: 100K/1%; R_0402_1005Metric
R46, R48, R55: 100R/1%; R_0402_1005Metric
R47: 1K/1%; R_0402_1005Metric
R50, R56: 10K/1%; R_0402_1005Metric; not fitted
R57: 75K/1%; R_0402_1005Metric
R60, R402, R412, R422, R432, R442, R452, R462: 22K/1%; R_0402_1005Metric
R471: 100K/1%; R_0402_1005Metric; not fitted
R472: 22K/1%; R_0402_1005Metric; not fitted
SW1, SW2: SW_Push; SW_Push_6x6x6
TP4, TP5, TP6, TP8, TP9: TestPoint; TestPoint_Pad_D1.5mm
U13: TL431DBZ; SOT-23
U15, U16, U400, U410, U420, U430, U440, U450, U460: SY8253ADC; TSOT-23-6
U470: SY8253ADC; TSOT-23-6; not fitted

Connections:
+3V3: C73.1, C75.2, C77.2, C79.1, C81.2, C83.2, L2.2, R50.2, R52.2, R56.2, R59.2, TP6.1
+3V3a: C404.1, C405.2, C406.2, C407.1, C408.2, C409.2, L401.2, R401.2
+3V3aa: C444.1, C445.2, C446.2, C447.1, C448.2, C449.2, L441.2, R441.2
+3V3b: C414.1, C415.2, C416.2, C417.1, C418.2, C419.2, L411.2, R411.2
+3V3bb: C454.1, C455.2, C456.2, C457.1, C458.2, C459.2, L451.2, R451.2
+3V3c: C424.1, C425.2, C426.2, C427.1, C428.2, C429.2, L421.2, R421.2
+3V3cc: C464.1, C465.2, C466.2, C467.1, C468.2, C469.2, L461.2, R461.2
+3V3d: C434.1, C435.2, C436.2, C437.1, C438.2, C439.2, L431.2, R431.2
+3V3dd: C474.1, C475.2, C476.2, C477.1, C478.2, C479.2, L471.2, R471.2
+5V: C72.1, C74.2, C76.2, C78.1, C80.2, C82.2, L1.2, R57.2, TP5.1
+12V: C63.2, D15.2 (A), D16.2 (A), D17.2 (A), J5.1, Q7.1 (S_1), Q7.2 (S_2), Q7.3 (S_3), R38.2, R40.2, R44.2, TP4.1
+12VA: Q7.5 (D_1), Q7.6 (D_2), Q7.7 (D_3), Q7.8 (D_4), Q7.9 (D_5), Q7.10 (D_6), Q7.11 (D_7), R54.1, TP8.1
GND: C62.2, C64.1, C65.1, C66.2, C67.1, C68.1, C69.2, C74.1, C75.1, C76.1, C77.1, C78.2, C79.2, C80.1, C81.1, C82.1, C83.1, C401.1, C402.1, C405.1, C406.1, C407.2, C408.1, C409.1, C411.1, C412.1, C415.1, C416.1, C417.2, C418.1, C419.1, C421.1, C422.1, C425.1, C426.1, C427.2, C428.1, C429.1, C431.1, C432.1, C435.1, C436.1, C437.2, C438.1, C439.1, C441.1, C442.1, C445.1, C446.1, C447.2, C448.1, C449.1, C451.1, C452.1, C455.1, C456.1, C457.2, C458.1, C459.1, C461.1, C462.1, C465.1, C466.1, C467.2, C468.1, C469.1, C471.1, C472.1, C475.1, C476.1, C477.2, C478.1, C479.1, D21.1 (A1), D23.1 (K), D24.2 (A), D25.1 (A1), J5.2, J5.3, J79.1, J80.1, Q6.2 (S), Q8.2 (S), R39.1, R42.1, R49.1, R51.1, R58.1, R60.1, R402.1, R412.1, R422.1, R432.1, R442.1, R452.1, R462.1, R472.1, SW1.2, SW2.2, U13.3 (A), U15.2 (GND), U16.2 (GND), U400.2 (GND), U410.2 (GND), U420.2 (GND), U430.2 (GND), U440.2 (GND), U450.2 (GND), U460.2 (GND), U470.2 (GND)
unnamed: C62.1, Q5.1 (G), R41.1, R42.2
unnamed: C63.1, Q7.4 (G), R44.1, R45.2
unnamed: C66.1, D21.2 (A2), J79.2, R48.1, R50.1, SW1.1
unnamed: C69.1, D25.2 (A2), J80.2, R55.1, R56.1, SW2.1
unnamed: C70.1, L1.1, U15.6 (SW)
unnamed: C70.2, U15.1 (BOOST)
unnamed: C71.1, L2.1, U16.6 (SW)
unnamed: C71.2, U16.1 (BOOST)
unnamed: C72.2, R57.1, R58.2, U15.3 (FB)
unnamed: C73.2, R59.1, R60.2, U16.3 (FB)
unnamed: C403.1, L401.1, U400.6 (SW)
unnamed: C403.2, U400.1 (BOOST)
unnamed: C404.2, R401.1, R402.2, U400.3 (FB)
unnamed: C413.1, L411.1, U410.6 (SW)
unnamed: C413.2, U410.1 (BOOST)
unnamed: C414.2, R411.1, R412.2, U410.3 (FB)
unnamed: C423.1, L421.1, U420.6 (SW)
unnamed: C423.2, U420.1 (BOOST)
unnamed: C424.2, R421.1, R422.2, U420.3 (FB)
unnamed: C433.1, L431.1, U430.6 (SW)
unnamed: C433.2, U430.1 (BOOST)
unnamed: C434.2, R431.1, R432.2, U430.3 (FB)
unnamed: C443.1, L441.1, U440.6 (SW)
unnamed: C443.2, U440.1 (BOOST)
unnamed: C444.2, R441.1, R442.2, U440.3 (FB)
unnamed: C453.1, L451.1, U450.6 (SW)
unnamed: C453.2, U450.1 (BOOST)
unnamed: C454.2, R451.1, R452.2, U450.3 (FB)
unnamed: C463.1, L461.1, U460.6 (SW)
unnamed: C463.2, U460.1 (BOOST)
unnamed: C464.2, R461.1, R462.2, U460.3 (FB)
unnamed: C473.1, L471.1, U470.6 (SW)
unnamed: C473.2, U470.1 (BOOST)
unnamed: C474.2, R471.1, R472.2, U470.3 (FB)
unnamed: D22.1 (K), Q8.3 (D)
unnamed: D22.2 (A), R52.1
unnamed: D23.2 (A), R54.2
unnamed: JP1.2 (C), R46.1
unnamed: Q5.2 (S), Q6.3 (D)
unnamed: Q5.3 (D), R45.1
unnamed: Q8.1 (G), R47.2, R49.2
unnamed: R38.1, R39.2, U13.2 (REF)
unnamed: R40.1, R41.2, U13.1 (K)
PWR_EN: Q6.1 (G), R46.2, R51.2, TP9.1, U15.4 (EN), U16.4 (EN), U400.4 (EN), U410.4 (EN), U420.4 (EN), U430.4 (EN), U440.4 (EN), U450.4 (EN), U460.4 (EN), U470.4 (EN)
SLS_S3: JP1.3 (B)
VDC: C64.2, C65.2, C67.2, C68.2, C401.2, C402.2, C411.2, C412.2, C421.2, C422.2, C431.2, C432.2, C441.2, C442.2, C451.2, C452.2, C461.2, C462.2, C471.2, C472.2, D15.1 (K), D16.1 (K), D17.1 (K), R53.1, U15.5 (VIN), U16.5 (VIN), U400.5 (VIN), U410.5 (VIN), U420.5 (VIN), U430.5 (VIN), U440.5 (VIN), U450.5 (VIN), U460.5 (VIN), U470.5 (VIN)
VPullup: D24.1 (K), R53.2
~PWR_LED/~PSON: JP1.1 (A), R47.1
~PWR_SW: R48.2
~RST_SW: R55.2

Notes on the sheet:
soft start
SY8253ADC 23V 3A 500kHz
LattePanda Mu has integrated pull-up resistors.
Power for PCIe x4 OVP@13.86V
Vout=0.6*(75+10)/10=5.1V
12V DC Input(12V 6A-10A)
PCIe Power Enable LED
Pullup power for bios_sel
Vout=0.6*(100+22)/22=3.327V
