El-Luhb/LattePanda-Mu/Electricals/Examples/nvme Carrier for LattePanda Mu/USB2.0&USB3.0.kicad_sch

## KiCad design Electricals/Examples/nvme Carrier for LattePanda Mu/USB2.0&USB3.0.kicad_sch (2024-06-21)

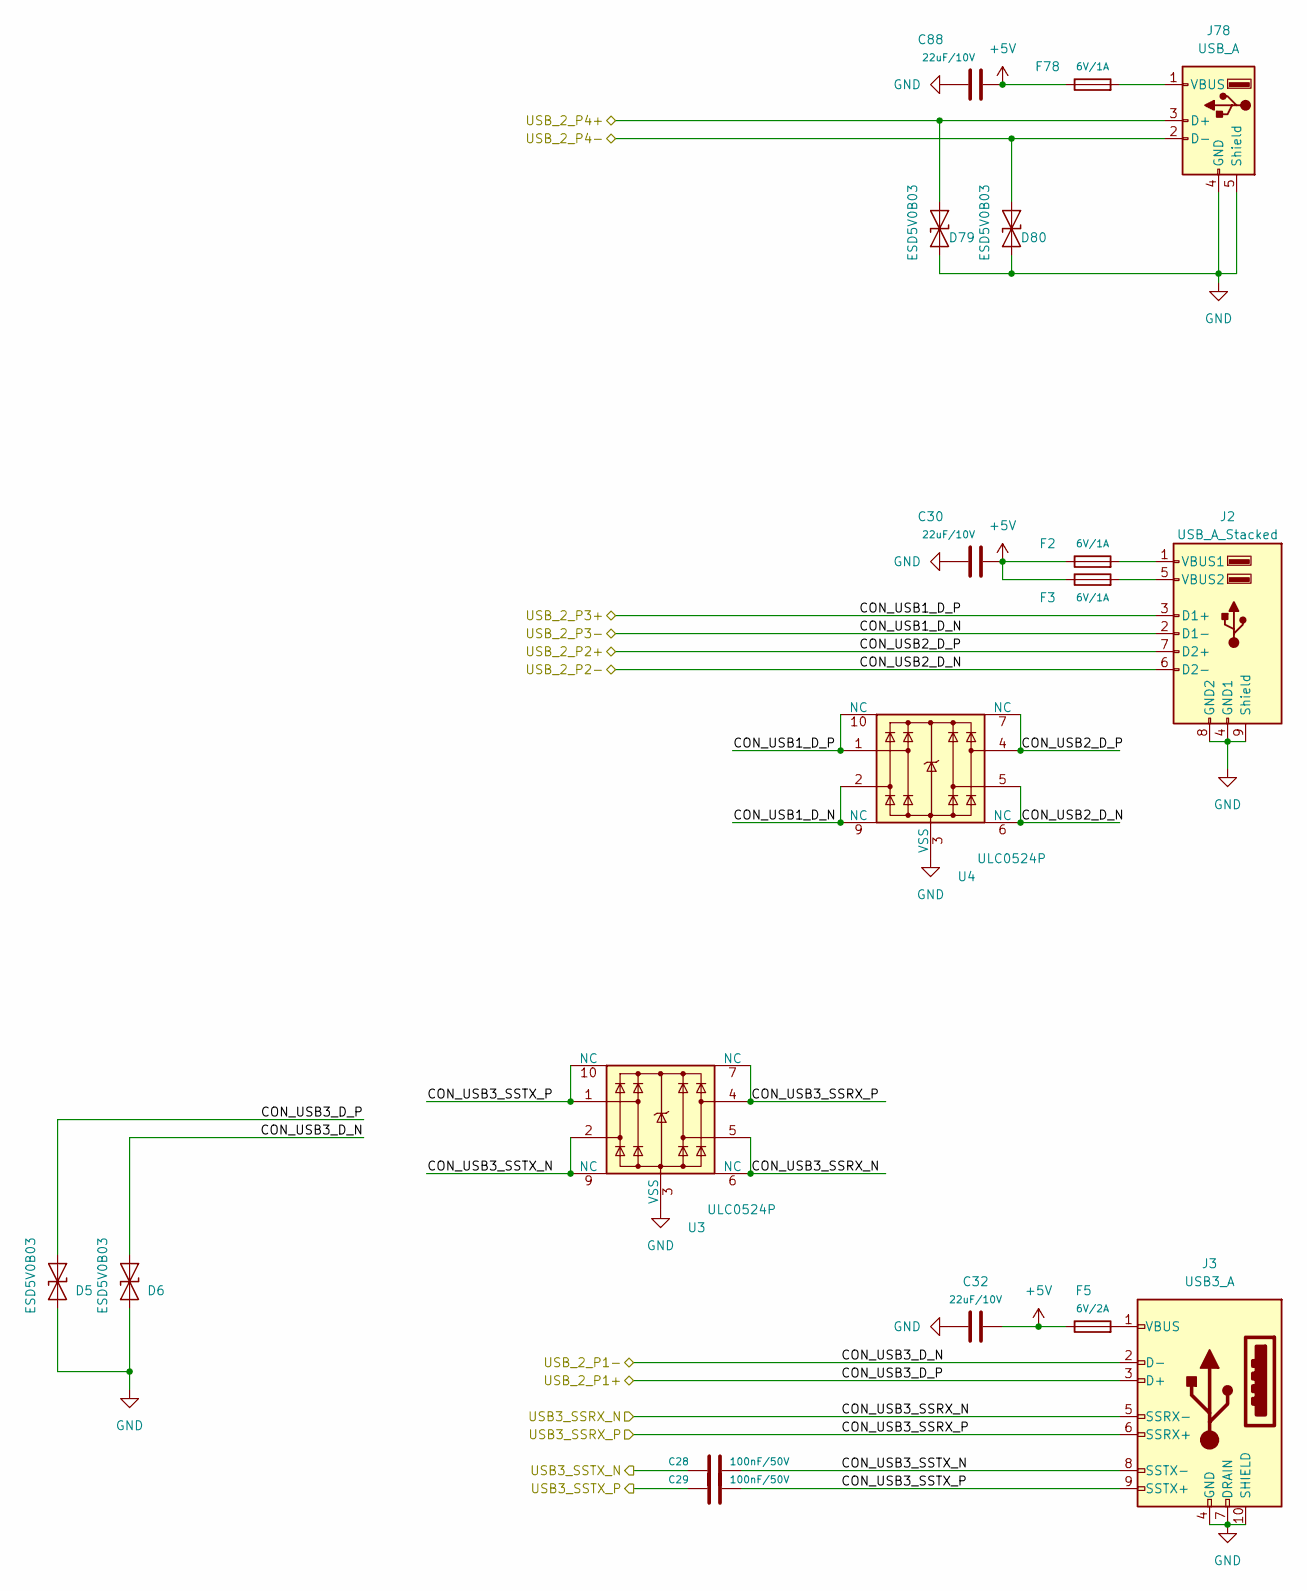
[picture p10: schematic USB2.0&USB3.0.kicad_sch]

Parts:
C28, C29: 100nF/50V; C_0402_1005Metric
C30, C32, C88: 22uF/10V; C_0603_1608Metric
D5, D6, D79, D80: ESD5V0B03; D_0402_1005Metric
F2, F3, F78: 6V/1A; Fuse_0805_2012Metric
F5: 6V/2A; Fuse_0805_2012Metric
J2: USB_A_Stacked; USB_A_CUI_UJ2-ADH-TH_Horizontal_Stacked
J3: USB3_A; USB3_A_Molex_48393-001
J78: USB_A; USB_A_Molex_105057_Vertical
U3, U4: ULC0524P; Diodes_UDFN-10_1.0x2.5mm_P0.5mm

Connections:
+5V: C30.2, C32.2, C88.2, F2.1, F3.1, F5.1, F78.1
CON_USB1_D_N: J2.2 (D1-), U4.2, U4.9 (NC)
CON_USB1_D_P: J2.3 (D1+), U4.1, U4.10 (NC)
CON_USB2_D_N: J2.6 (D2-), U4.5, U4.6 (NC)
CON_USB2_D_P: J2.7 (D2+), U4.4, U4.7 (NC)
CON_USB3_D_N: D6.2 (A2), J3.2 (D-)
CON_USB3_D_P: D5.2 (A2), J3.3 (D+)
CON_USB3_SSRX_N: J3.5 (SSRX-), U3.5, U3.6 (NC)
CON_USB3_SSRX_P: J3.6 (SSRX+), U3.4, U3.7 (NC)
CON_USB3_SSTX_N: C28.2, J3.8 (SSTX-), U3.2, U3.9 (NC)
CON_USB3_SSTX_P: C29.2, J3.9 (SSTX+), U3.1, U3.10 (NC)
GND: C30.1, C32.1, C88.1, D5.1 (A1), D6.1 (A1), D79.1 (A1), D80.1 (A1), J2.4 (GND1), J2.8 (GND2), J2.9 (Shield), J3.4 (GND), J3.7 (DRAIN), J3.10 (SHIELD), J78.4 (GND), J78.5 (Shield), U3.3 (VSS), U3.8 (VSS), U4.3 (VSS), U4.8 (VSS)
unnamed: F2.2, J2.1 (VBUS1)
unnamed: F3.2, J2.5 (VBUS2)
unnamed: F5.2, J3.1 (VBUS)
unnamed: F78.2, J78.1 (VBUS)
USB3_SSTX_N: C28.1
USB3_SSTX_P: C29.1
USB_2_P4+: D79.2 (A2), J78.3 (D+)
USB_2_P4-: D80.2 (A2), J78.2 (D-)
