El-Luhb/LattePanda-Mu/Electricals/Examples/nvme Carrier for LattePanda Mu/nvme Carrier for LattePanda Mu.kicad_sch

## KiCad design Electricals/Examples/nvme Carrier for LattePanda Mu/nvme Carrier for LattePanda Mu.kicad_sch (2024-06-21)

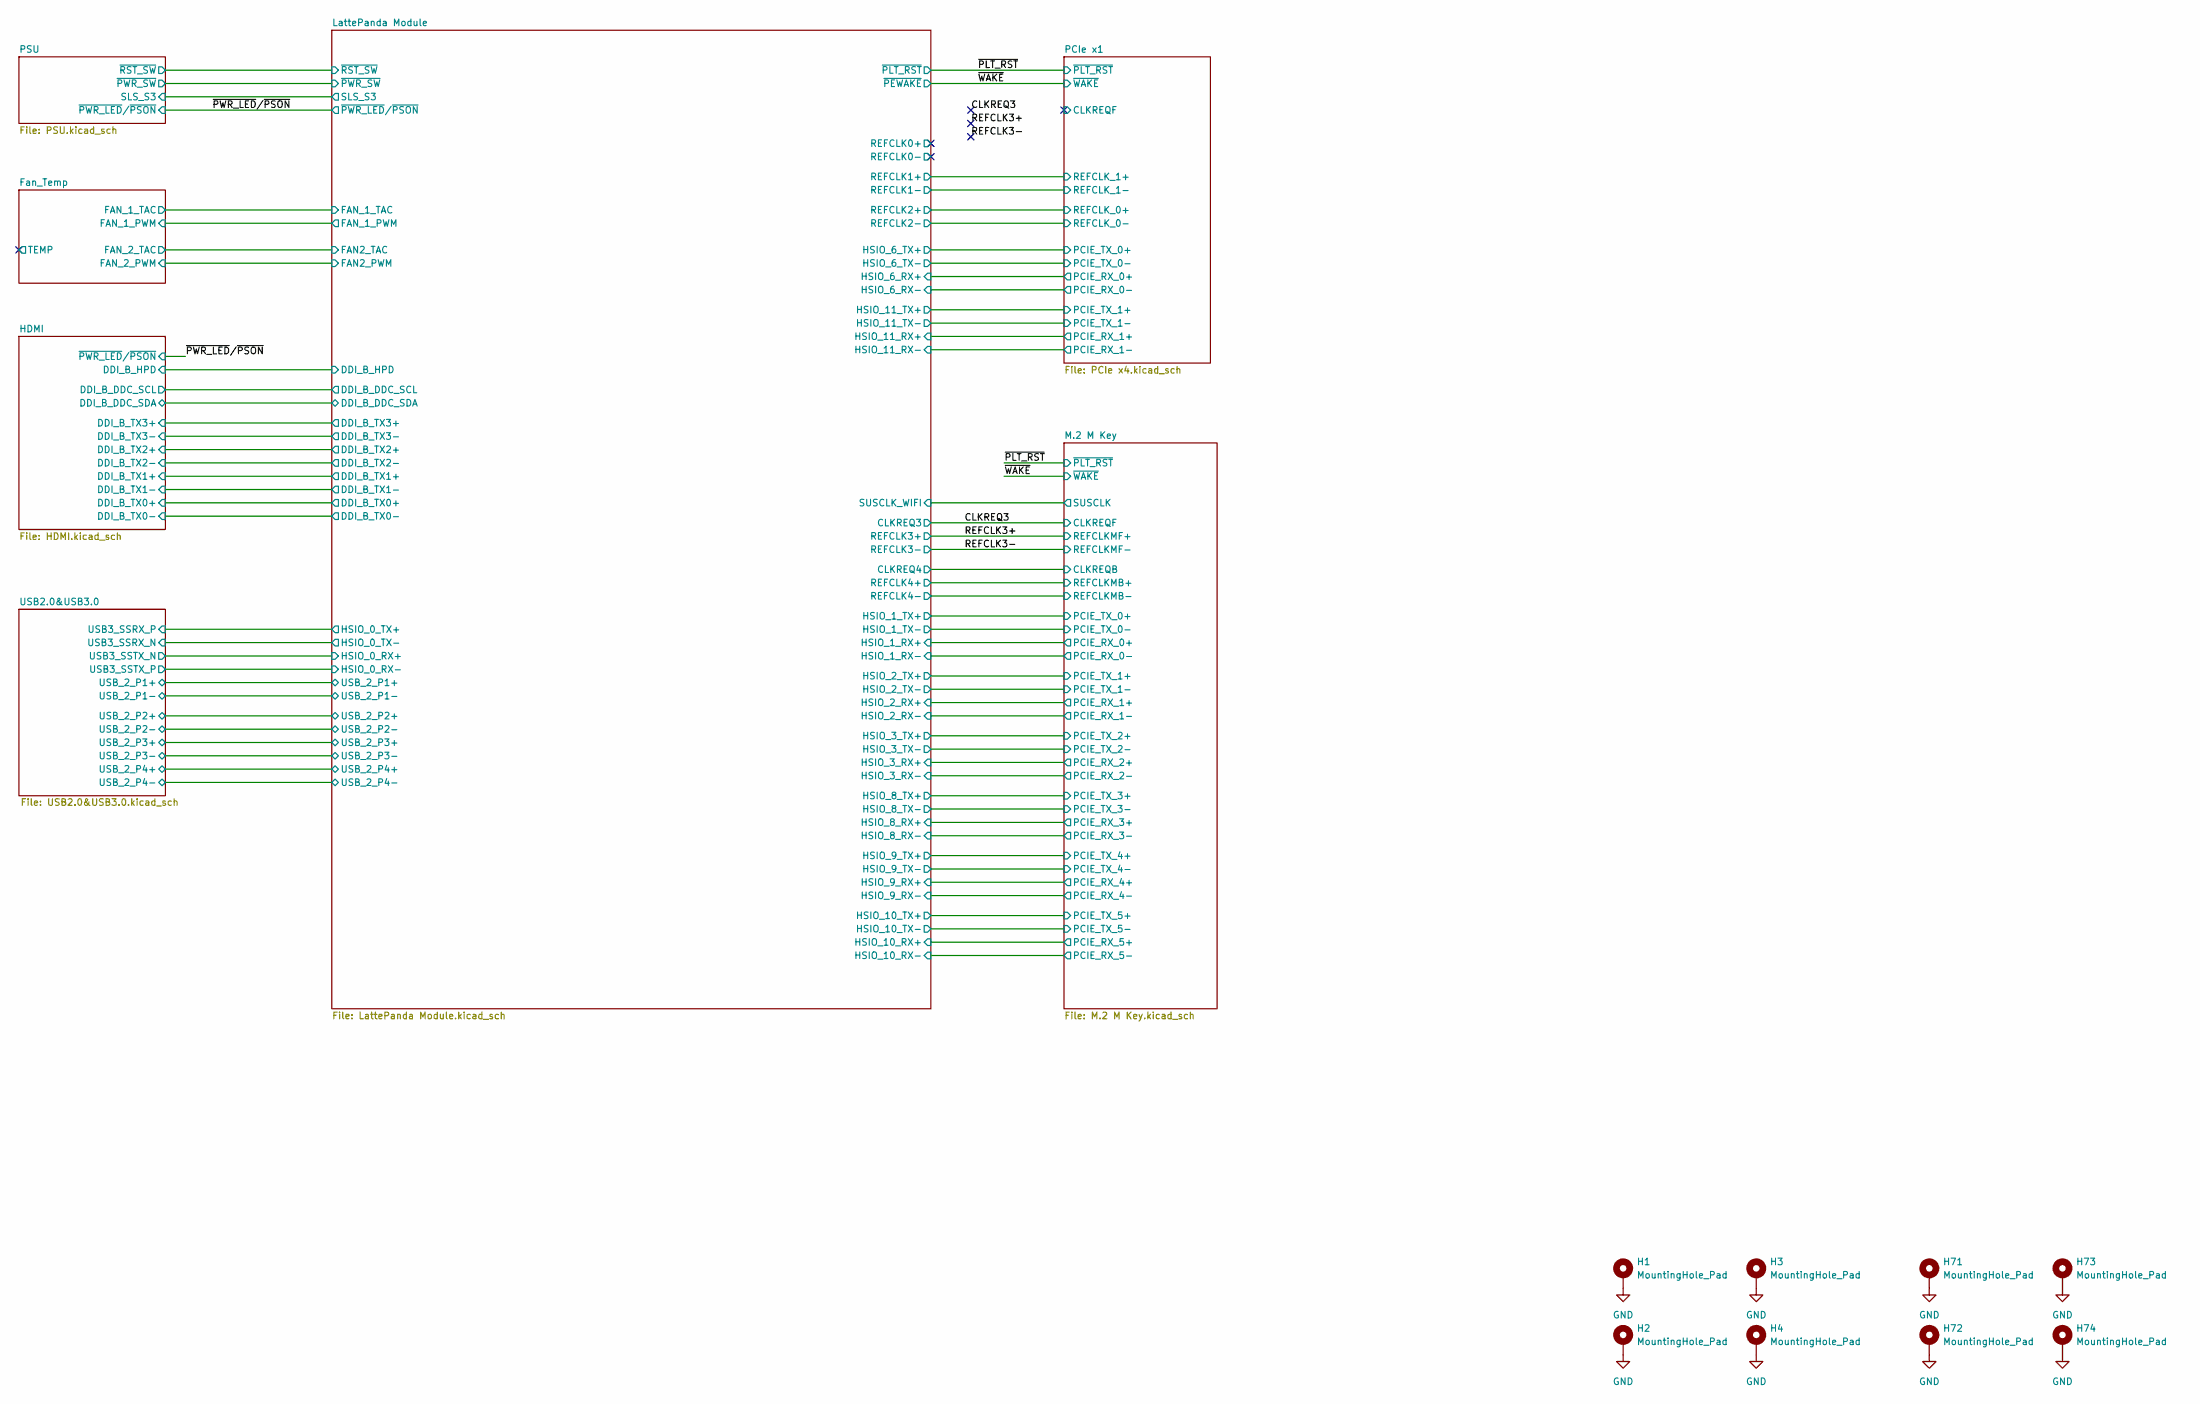
[picture p11: schematic nvme Carrier for LattePanda Mu.kicad_sch]

Parts:
H1, H2, H3, H4, H71, H72, H73, H74: MountingHole_Pad; MountingHole_3.2mm_M3_Pad_Via

Connections:
GND: H1.1, H2.1, H3.1, H4.1, H71.1, H72.1, H73.1, H74.1
